bcimring/wheelchair_controller/README.md

# wheelchair_controller
A project involving the control software and hardware required for a functioning electronic wheelchair.
