bcimring/wheelchair_controller/required_hardware.txt

What we need:

Barry 
//- massive capacitor
----- op amps for voltage translation
----- decoupling capacitors
- LCD display
//- Battery Enery Level Detector
//- Wheel Motor
//- motor encoder

Anweshi
- LEDs
- Switches (for locked/run mode)
- potentiometers 
	1 for speed
	1 for steering
	or one joystick type of thing for both
