bcimring/wheelchair_controller/lab_4/ECE298_Lab4_Netlist.TXT

ISIS SCHEMATIC DESCRIPTION FORMAT 8.0
=====================================
Design:   ECE298_Lab4.pdsprj
Doc. no.: <NONE>
Revision: <NONE>
Author:   <NONE>
Created:  2020-12-15
Modified: 2021-08-03

*PROPERTIES,0    

*MODELDEFS,0    

*PARTLIST,83   
+3.3V,PIN,PIN,EID=1A,PACKAGE=PIN
+5V,PIN,PIN,EID=18,PACKAGE=PIN
+12V,PIN,PIN,EID=15,PACKAGE=PIN
C1,AVX0805X7R10N,10n,CODE="Farnell 499-225",EID=7,PACKAGE=0805_CAP
C2,AVX0805X7R10N,10n,CODE="Farnell 499-225",EID=9,PACKAGE=0805_CAP
C3,AVX0805X7R10N,10n,CODE="Farnell 499-225",EID=B,PACKAGE=0805_CAP
C4,C2012Y5V1A106Z,10u,CODE="Digikey 445-1371-1-ND",EID=D,PACKAGE=CAPC2012X100
C5,C2012Y5V1A106Z,10u,CODE="Digikey 445-1371-1-ND",EID=F,PACKAGE=CAPC2012X100
C6,C2012Y5V1A106Z,10u,CODE="Digikey 445-1371-1-ND",EID=1E,PACKAGE=CAPC2012X100
C7,AVX0805X7R10N,10n,CODE="Farnell 499-225",EID=21,PACKAGE=0805_CAP
C8,AVX0805X7R10N,10n,CODE="Farnell 499-225",EID=6,PACKAGE=0805_CAP
C9,AVX0805X7R10N,10n,CODE="Farnell 499-225",EID=25,PACKAGE=0805_CAP
C10,AVX0805X7R10N,10n,CODE="Farnell 499-225",EID=26,PACKAGE=0805_CAP
C11,AVX0805X7R10N,10n,CODE="Farnell 499-225",EID=27,PACKAGE=0805_CAP
C12,B45196H1107M209,100u,CODE="Digikey 495-2191-2-ND",EID=23,PACKAGE=CAPMP3528X210
C13,B45196H1107M209,100u,CODE="Digikey 495-2191-2-ND",EID=29,PACKAGE=CAPMP3528X210
C14,C2012Y5V1A106Z,10u,CODE="Digikey 445-1371-1-ND",EID=37,PACKAGE=CAPC2012X100
CN7,1-534236-9,1-534236-9,CODE=1-534236-9,EID=8,PACKAGE=ECE298_REVTRANS38DIL-1,SUPPLIER=TE_CONNECTIVITY
CN10,1-534236-9,1-534236-9,CODE=1-534236-9,EID=2,PACKAGE=ECE298_REVTRANS38DIL-1,SUPPLIER=TE_CONNECTIVITY
GND,PIN,PIN,EID=24,PACKAGE=PIN
J1,TBLOCK-M2,TBLOCK-M2,EID=5,PACKAGE=TBLOCK-M2
J4,26630201RP2,26630201RP2,CODE="NorComp 26630201RP2",EID=4,PACKAGE=CON2_1X2_HDR_2663
J5,26630201RP2,26630201RP2,CODE="NorComp 26630201RP2",EID=E,PACKAGE=CON2_1X2_HDR_2663
J6,26641201RP2,26641201RP2,CODE="NorComp 26641201RP2",EID=22,PACKAGE=CON12_2X6_HDR_2664
J7,26641001RP2,26641001RP2,CODE="NorComp 26641001RP2",EID=12,PACKAGE=CON10_2X5_HDR_2664
J9,27640602RP2,27640602RP2,CODE="NorComp 27640602RP2",EID=C,PACKAGE=CON6_2X3_HDR_2764
J16,26640801RP2,26640801RP2,CODE="NorComp 26640801RP2",EID=28,PACKAGE=CON8_2X4_HDR_2664
PWM1,PIN,PIN,EID=1C,PACKAGE=PIN
PWM2,PIN,PIN,EID=1B,PACKAGE=PIN
Q1,2N7002,2N7002,CODE="Digikey 2N7002NTR-ND",EID=1D,PACKAGE=SOT95P230X109-3
Q2,2N7002,2N7002,CODE="Digikey 2N7002NTR-ND",EID=2C,PACKAGE=SOT95P230X109-3
Q3,2N7002,2N7002,CODE="Digikey 2N7002NTR-ND",EID=4B,PACKAGE=SOT95P230X109-3
Q4,2N7002,2N7002,CODE="Digikey 2N7002NTR-ND",EID=30,PACKAGE=SOT95P230X109-3
Q17,2N7002,2N7002,CODE="Digikey 2N7002NTR-ND",EID=57,PACKAGE=SOT95P230X109-3
Q18,2N7002,2N7002,CODE="Digikey 2N7002NTR-ND",EID=33,PACKAGE=SOT95P230X109-3
Q19,2N7002,2N7002,CODE="Digikey 2N7002NTR-ND",EID=38,PACKAGE=SOT95P230X109-3
Q20,2N7002,2N7002,CODE="Digikey 2N7002NTR-ND",EID=46,PACKAGE=SOT95P230X109-3
Q21,2N7002,2N7002,CODE="Digikey 2N7002NTR-ND",EID=10,PACKAGE=SOT95P230X109-3
Q22,2N7002,2N7002,CODE="Digikey 2N7002NTR-ND",EID=4E,PACKAGE=SOT95P230X109-3
Q23,2N7002,2N7002,CODE="Digikey 2N7002NTR-ND",EID=53,PACKAGE=SOT95P230X109-3
Q24,2N7002,2N7002,CODE="Digikey 2N7002NTR-ND",EID=56,PACKAGE=SOT95P230X109-3
Q25,2N7002,2N7002,CODE="Digikey 2N7002NTR-ND",EID=5E,PACKAGE=SOT95P230X109-3
Q26,2N7002,2N7002,CODE="Digikey 2N7002NTR-ND",EID=13,PACKAGE=SOT95P230X109-3
Q27,2N7002,2N7002,CODE="Digikey 2N7002NTR-ND",EID=16,PACKAGE=SOT95P230X109-3
Q28,2N7002,2N7002,CODE="Digikey 2N7002NTR-ND",EID=19,PACKAGE=SOT95P230X109-3
R1,ERA-6YEB104V,100K,CODE="Digikey P100KZTR-ND",EID=5F,PACKAGE=RESC2012X50,PRIMTYPE=RESISTOR
R2,ERA-6YEB104V,100K,CODE="Digikey P100KZTR-ND",EID=60,PACKAGE=RESC2012X50,PRIMTYPE=RESISTOR
R3,ERA-6YEB104V,100K,CODE="Digikey P100KZTR-ND",EID=2B,PACKAGE=RESC2012X50,PRIMTYPE=RESISTOR
R4,RT0805DRE07300KL,300k,CODE="Digikey RT0805DRE07300KL-ND",EID=6D,PACKAGE=RESC2012X50,PRIMTYPE=RESISTOR
R13,RT0805DRE07165KL,165k,CODE="Digikey RT0805DRE07165KL-ND",EID=78,PACKAGE=RESC2012X50,PRIMTYPE=RESISTOR
R14,ERA-6YEB104V,100K,CODE="Digikey P100KZTR-ND",EID=6E,PACKAGE=RESC2012X50,PRIMTYPE=RESISTOR
R16,ERA-6YEB104V,100K,CODE="Digikey P100KZTR-ND",EID=2F,PACKAGE=RESC2012X50,PRIMTYPE=RESISTOR
R17,RT0805DRE07165KL,165k,CODE="Digikey RT0805DRE07165KL-ND",EID=79,PACKAGE=RESC2012X50,PRIMTYPE=RESISTOR
R18,RT0805DRE07330KL,330k,CODE="Digikey RT0805DRE07330KL-ND",EID=7A,PACKAGE=RESC2012X50,PRIMTYPE=RESISTOR
R19,9C08052A2000FKHFT,200,CODE="Digikey 311-200CTR-ND",EID=73,PACKAGE=RESC2012X50,PRIMTYPE=RESISTOR
R20,RT0805DRE07330KL,330k,CODE="Digikey RT0805DRE07330KL-ND",EID=7B,PACKAGE=RESC2012X50,PRIMTYPE=RESISTOR
R21,RT0805DRE07255KL,255k,CODE="Digikey RT0805DRE07255KL-ND",EID=3,PACKAGE=RESC2012X50,PRIMTYPE=RESISTOR
R22,RT0805DRE0764K9L,64.9k,CODE="Digikey RT0805DRE0764K9L-ND",EID=74,PACKAGE=RESC2012X50,PRIMTYPE=RESISTOR
R26,RT0805DRE0764K9L,64.9k,CODE="Digikey RT0805DRE0764K9L-ND",EID=75,PACKAGE=RESC2012X50,PRIMTYPE=RESISTOR
R27,ERA-6YEB104V,100K,CODE="Digikey P100KZTR-ND",EID=32,PACKAGE=RESC2012X50,PRIMTYPE=RESISTOR
R28,RT0805DRE07300KL,300k,CODE="Digikey RT0805DRE07300KL-ND",EID=6C,PACKAGE=RESC2012X50,PRIMTYPE=RESISTOR
R29,RT0805DRE07165KL,165k,CODE="Digikey RT0805DRE07165KL-ND",EID=76,PACKAGE=RESC2012X50,PRIMTYPE=RESISTOR
R30,RT0805DRE07165KL,165k,CODE="Digikey RT0805DRE07165KL-ND",EID=77,PACKAGE=RESC2012X50,PRIMTYPE=RESISTOR
R31,RT0805DRE07330KL,330k,CODE="Digikey RT0805DRE07330KL-ND",EID=7C,PACKAGE=RESC2012X50,PRIMTYPE=RESISTOR
R32,RT0805DRE07330KL,330k,CODE="Digikey RT0805DRE07330KL-ND",EID=7D,PACKAGE=RESC2012X50,PRIMTYPE=RESISTOR
R33,ERA-6YEB104V,100K,CODE="Digikey P100KZTR-ND",EID=36,PACKAGE=RESC2012X50,PRIMTYPE=RESISTOR
R34,ERA-6YEB104V,100K,CODE="Digikey P100KZTR-ND",EID=3D,PACKAGE=RESC2012X50,PRIMTYPE=RESISTOR
R35,ERA-6YEB104V,100K,CODE="Digikey P100KZTR-ND",EID=48,PACKAGE=RESC2012X50,PRIMTYPE=RESISTOR
R36,9C08052A2000FKHFT,200,CODE="Digikey 311-200CTR-ND",EID=11,PACKAGE=RESC2012X50,PRIMTYPE=RESISTOR
R37,ERA-6YEB104V,100K,CODE="Digikey P100KZTR-ND",EID=50,PACKAGE=RESC2012X50,PRIMTYPE=RESISTOR
R38,ERA-6YEB104V,100K,CODE="Digikey P100KZTR-ND",EID=55,PACKAGE=RESC2012X50,PRIMTYPE=RESISTOR
R39,ERA-6YEB104V,100K,CODE="Digikey P100KZTR-ND",EID=5B,PACKAGE=RESC2012X50,PRIMTYPE=RESISTOR
R40,ERA-6YEB104V,100K,CODE="Digikey P100KZTR-ND",EID=62,PACKAGE=RESC2012X50,PRIMTYPE=RESISTOR
R41,9C08052A2000FKHFT,200,CODE="Digikey 311-200CTR-ND",EID=14,PACKAGE=RESC2012X50,PRIMTYPE=RESISTOR
R42,9C08052A2000FKHFT,200,CODE="Digikey 311-200CTR-ND",EID=17,PACKAGE=RESC2012X50,PRIMTYPE=RESISTOR
R43,9C08052A2000FKHFT,200,CODE="Digikey 311-200CTR-ND",EID=1F,PACKAGE=RESC2012X50,PRIMTYPE=RESISTOR
RS,PIN,PIN,EID=1,PACKAGE=PIN
U1,LM2904LVIDDF,LM2904LVIDDF,EID_A=20,PACKAGE=SOT65P275X110-8,SPICELIB=TEXAS.SML,SPICEMODEL=LM2904LV,SPICEPINS="+IP,-IP,V+,V-,OP"
U3,4049,4049,EID_A=35,EID_B=4F,EID_C=4C,EID_D=2A,EID_F=61,ITFMOD=CMOS,MODFILE=40INV,PACKAGE=DIL16,VDD=+5.0V,VOLTAGE=5V,VSS=GND
U4,DRV8871,DRV8871,EID=2D,PACKAGE=SOIC127P600X170-9
U6,DRV8871,DRV8871,EID=34,PACKAGE=SOIC127P600X170-9
U7,4049,4049,EID_A=2E,EID_B=39,EID_C=47,EID_D=31,EID_E=58,EID_F=54,ITFMOD=CMOS,MODFILE=40INV,PACKAGE=DIL16,VDD=+5.0V,VOLTAGE=5V,VSS=GND
U10,74HCT238,74HCT238,EID=A,ITFMOD=TTLHCT,PACKAGE=DIL16,VCC=+5.0V

*NETLIST,79   
DRV1 IN1,3,CLASS=SIGNAL
DRV1 IN1,LBL
U4,IP,3
U10,OP,15

DRV1 IN2,3,CLASS=SIGNAL
DRV1 IN2,LBL
U4,IP,2
U10,OP,14

DRV1_OUT1,3,CLASS=POWER
DRV1_OUT1,LBL
U4,OP,6
J6,PS,10

DRV1_OUT2,3,CLASS=POWER
DRV1_OUT2,LBL
U4,OP,8
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
+5.0V,PR
J6,PS,4
C12,PS,1
J6,PS,3
C13,PS,1
C11,PS,1
C10,PS,1
C9,PS,1
R43,PS,1
R42,PS,1
R41,PS,1
R36,PS,1
CN7,PS,18
U10,PP,16
U3,PP,1
R40,PS,1
U7,PP,1
R39,PS,1
R38,PS,1
R37,PS,1
R35,PS,1
R34,PS,1
R33,PS,1
R27,PS,1
R16,PS,1
R3,PS,1
C5,PS,1
+5V,PS,1
R19,PS,1
R2,PS,1
C1,PS,1
J7,PS,1

+12.0V,11,CLASS=POWER
+12.0V,PR
U1,PP,8
C7,PS,1
U1,IP,2
C4,PS,1
J1,PS,1
+12V,PS,1
U6,PP,5
C2,PS,1
U4,PP,5
C3,PS,1

GND,66,CLASS=POWER
GND,PR
C13,PS,2
C12,PS,2
J6,PS,2
J6,PS,1
C11,PS,2
C10,PS,2
C9,PS,2
GND,PS,1
Q28,PS,2
Q27,PS,2
Q26,PS,2
Q21,PS,2
CN10,PS,9
CN10,PS,32
CN10,PS,20
CN7,PS,8
CN7,PS,22
CN7,PS,20
CN7,PS,19
C8,PS,2
U10,PP,8
U3,PP,8
Q25,PS,2
U7,PP,8
Q24,PS,2
Q23,PS,2
Q22,PS,2
Q20,PS,2
Q19,PS,2
Q18,PS,2
Q4,PS,2
Q2,PS,2
Q1,PS,2
C7,PS,2
U1,PP,4
C6,PS,2
C14,PS,2
C5,PS,2
C3,PS,2
C2,PS,2
C1,PS,2
J1,PS,2
C4,PS,2
R32,PS,2
R31,PS,2
R14,PS,2
R1,PS,2
Q17,PS,2
Q3,PS,2
U10,IP,6
U10,IP,3
U6,PP,7
U6,PP,9
U6,PP,1
R22,PS,2
U4,PP,7
U4,PP,9
U4,PP,1
R26,PS,2
R20,PS,2
R18,PS,2
J9,PS,6
J9,PS,5
J7,PS,3
J7,PS,5
