bcimring/wheelchair_controller/lab_1/lab_report_images.docx

Brushless Motor Images:

Symbol:

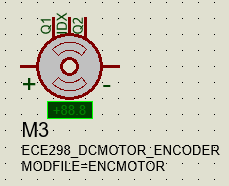
[picture p1: figure]
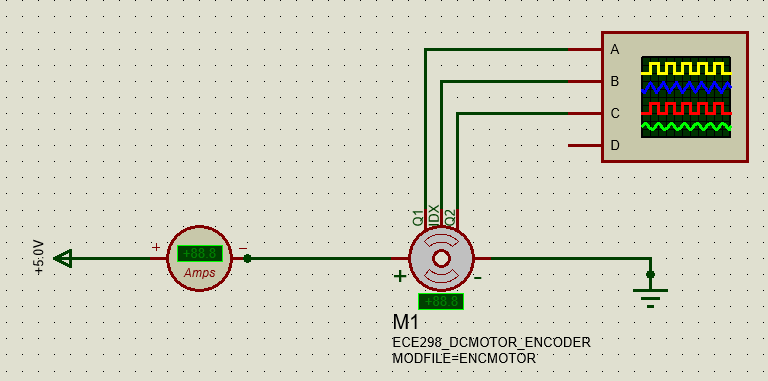
[picture p2: figure]

1 V, 1 pin

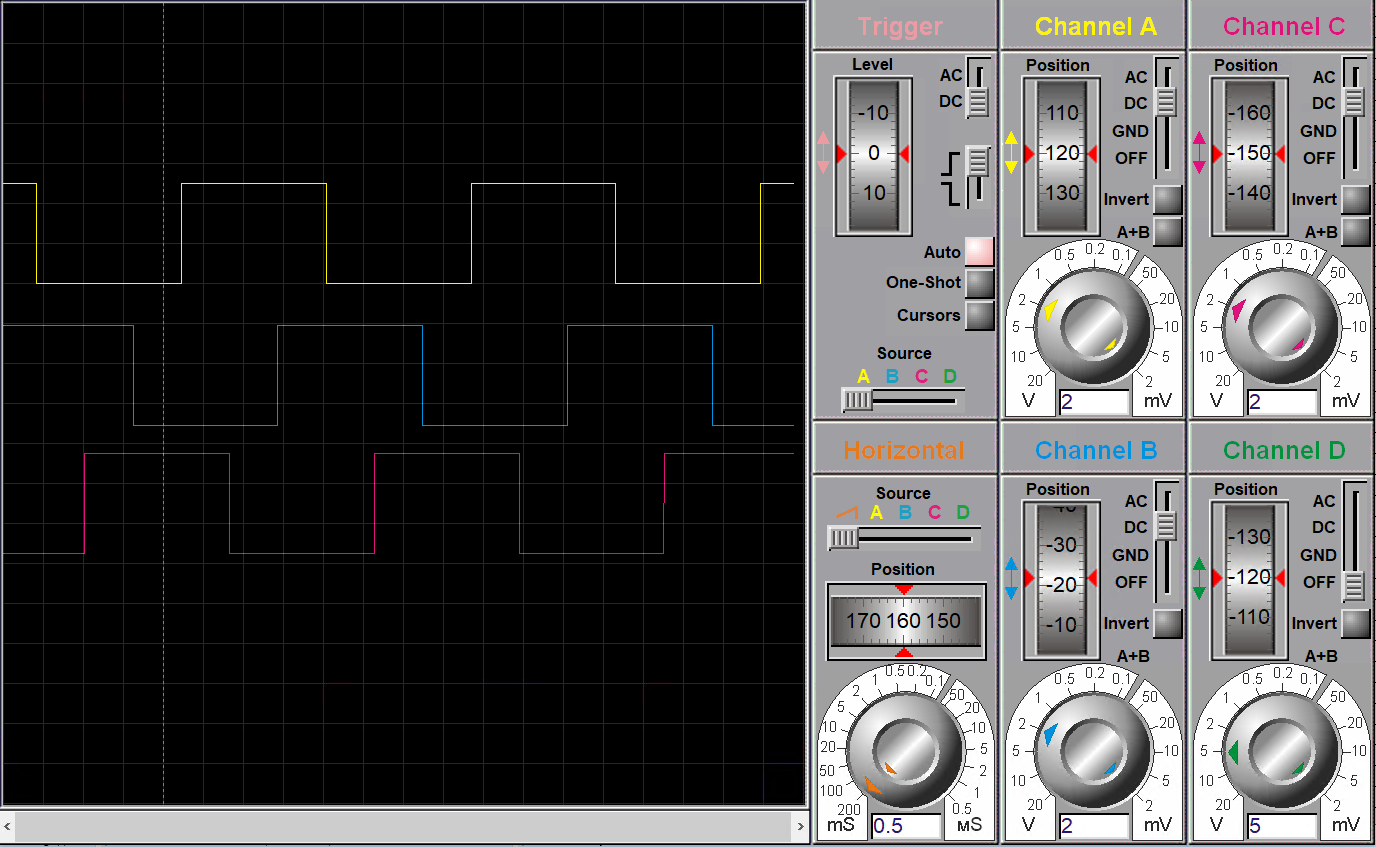
[picture p3: figure]
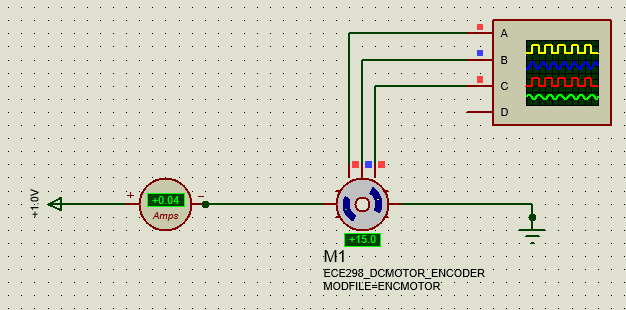
[picture p4: figure]

-1 V, 1 pin:

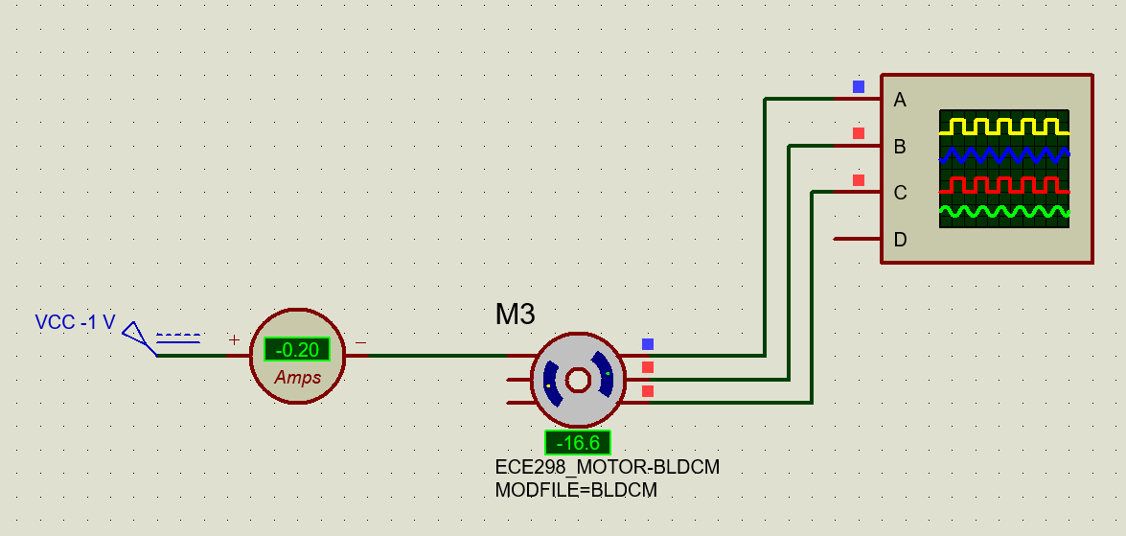
[picture p5: figure]
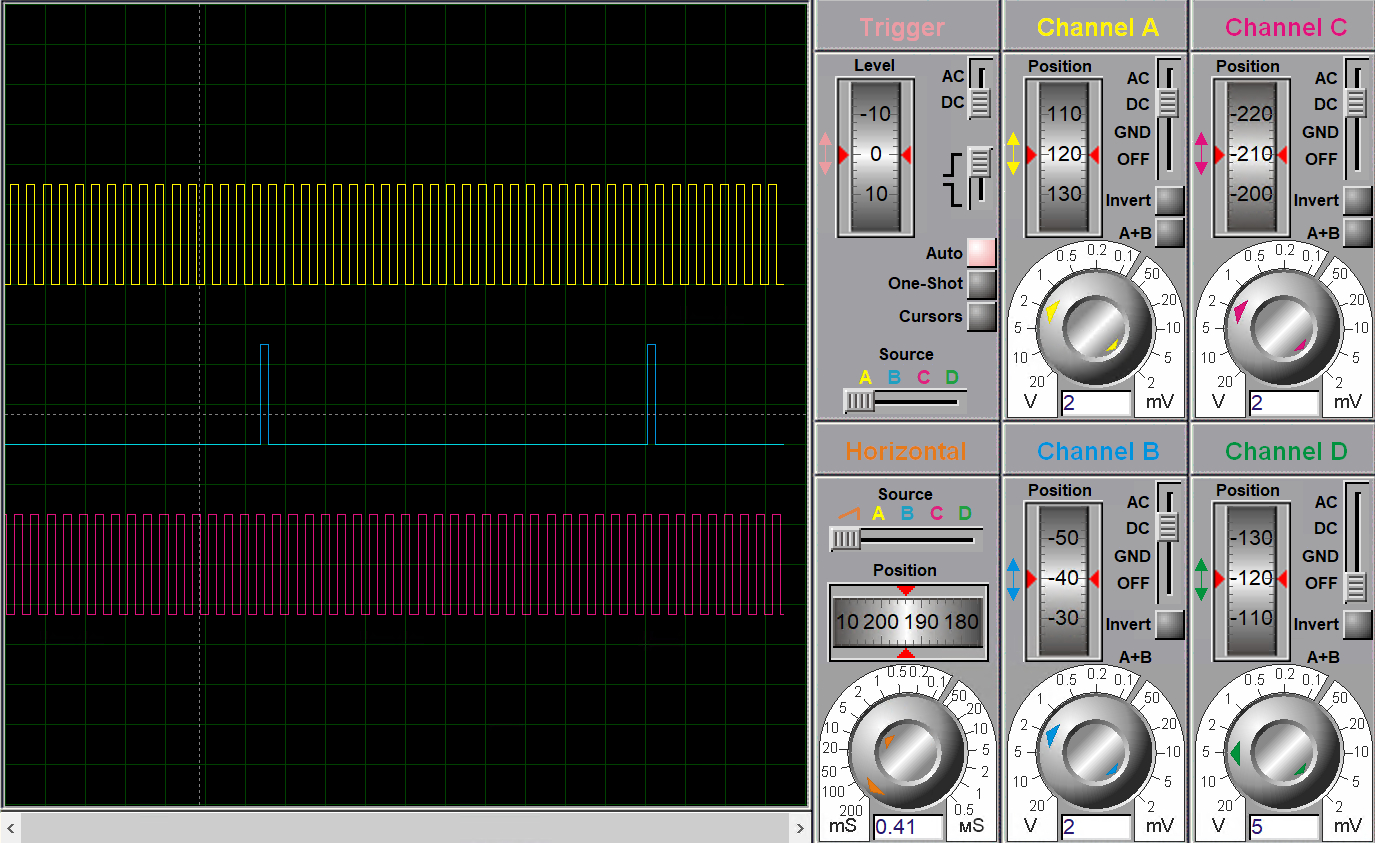
[picture p6: figure]
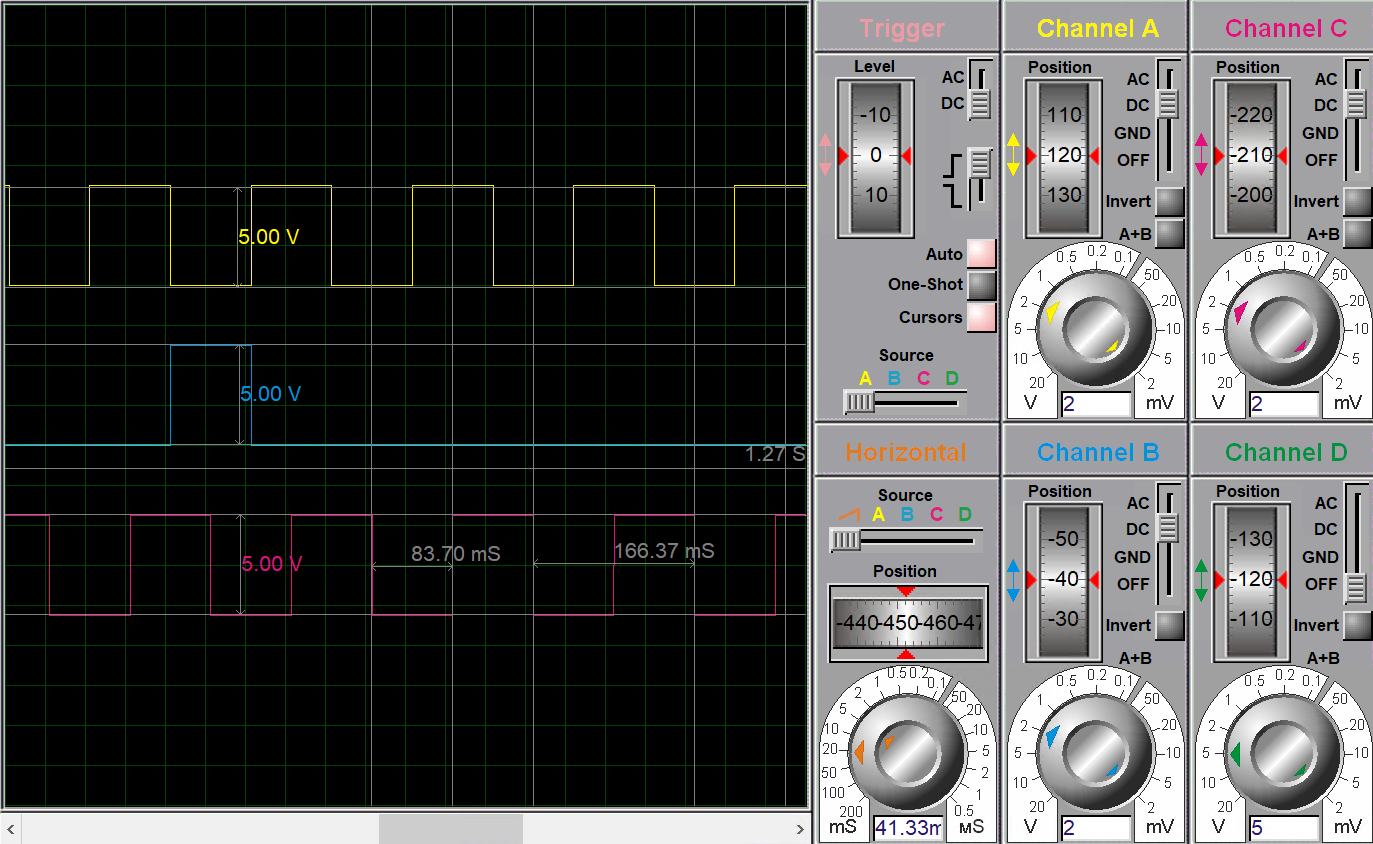
[picture p7: figure]

2 V, 1 pin:

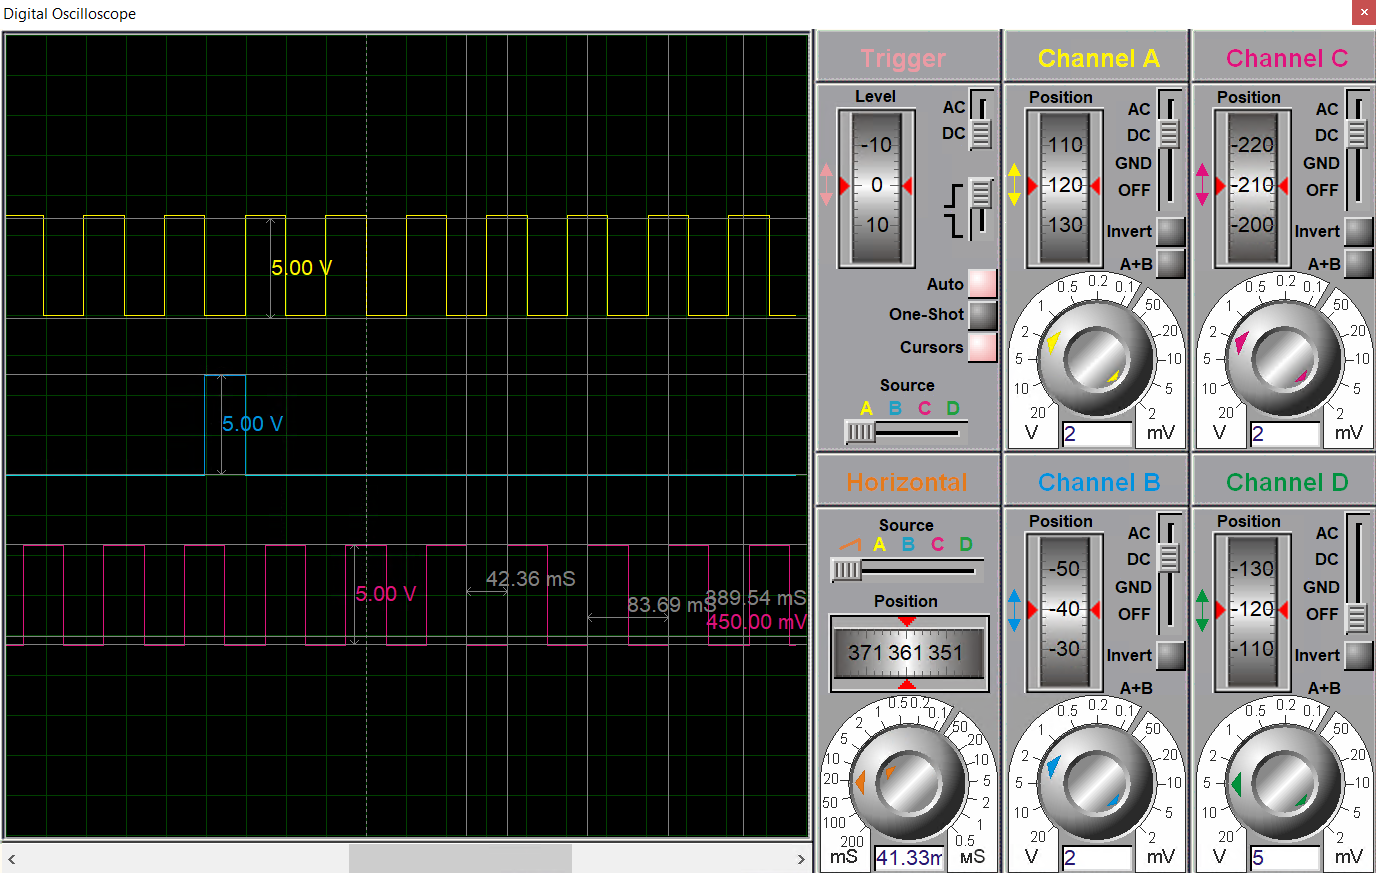
[picture p8: figure]
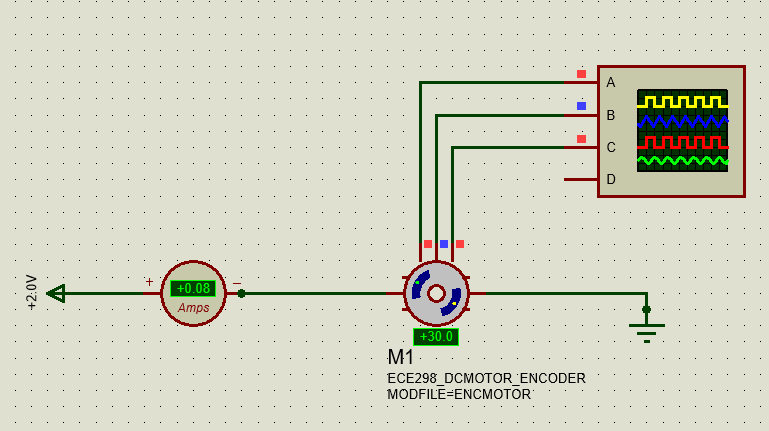
[picture p9: figure]

-1 V:

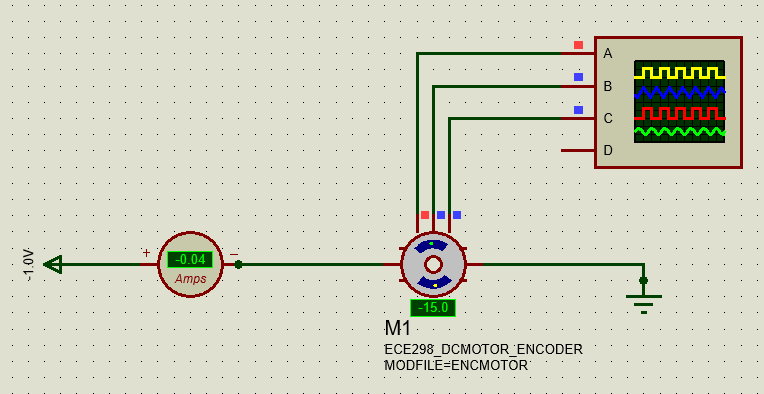
[picture p10: figure]
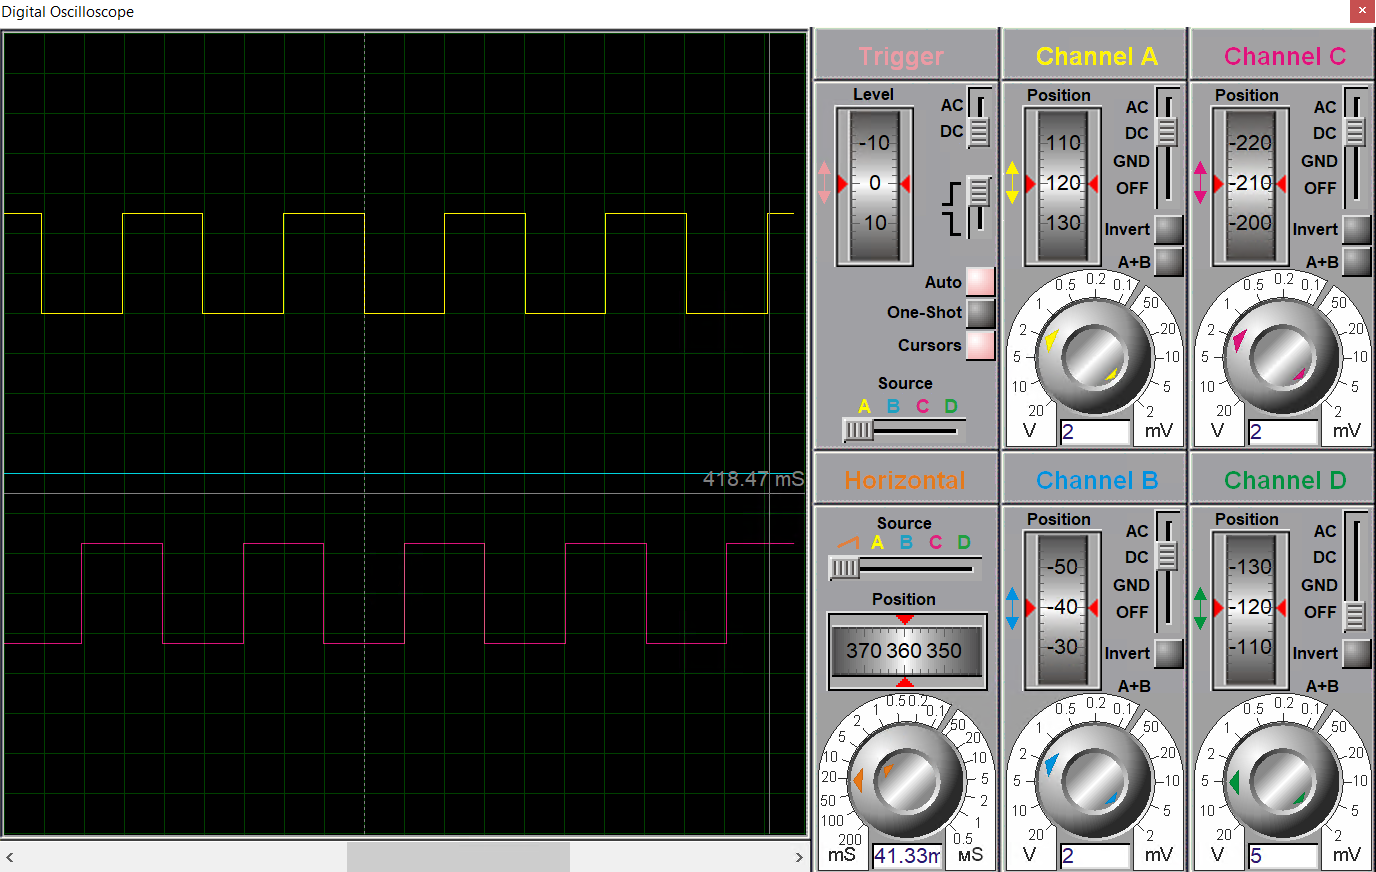
[picture p11: figure]

Battery voltage level detector:

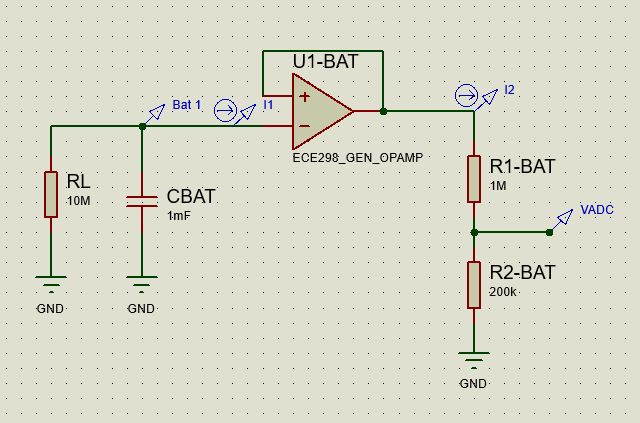
[picture p12: figure]
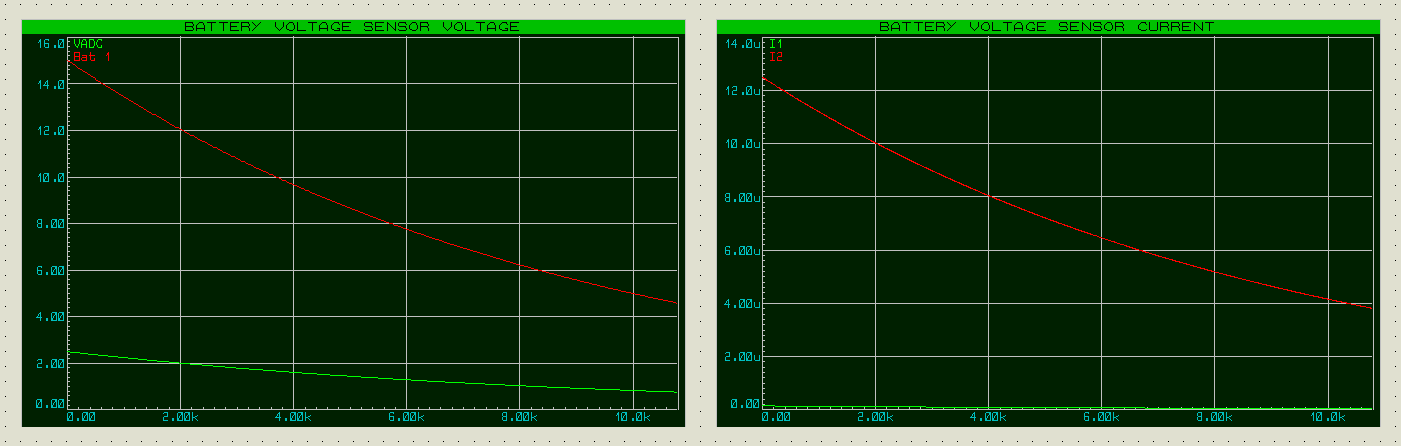
[picture p13: figure]

LCD:

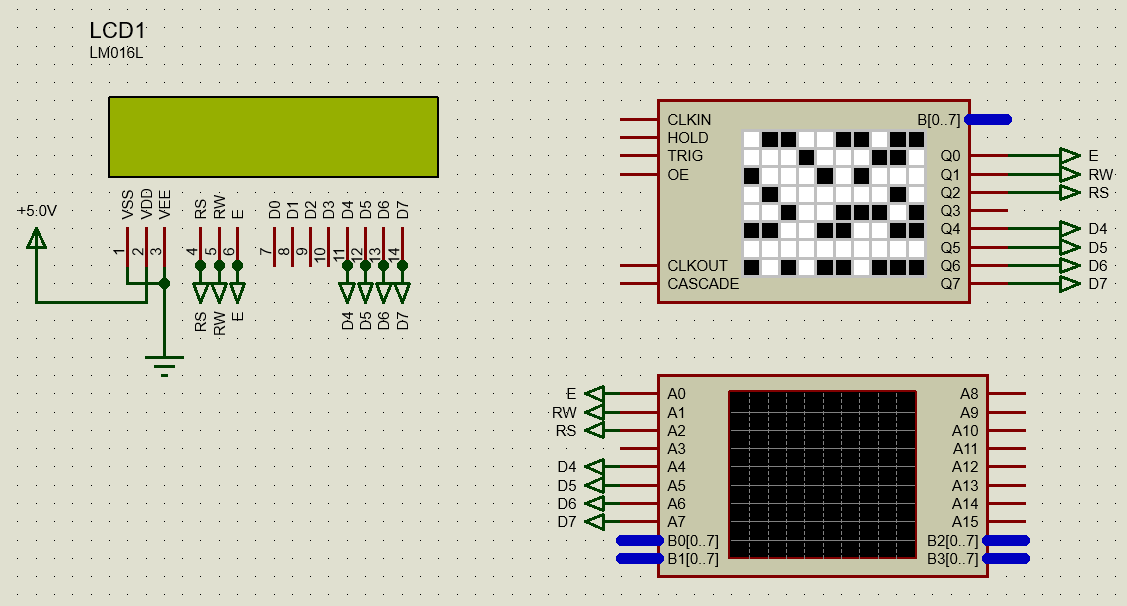
[picture p14: figure]
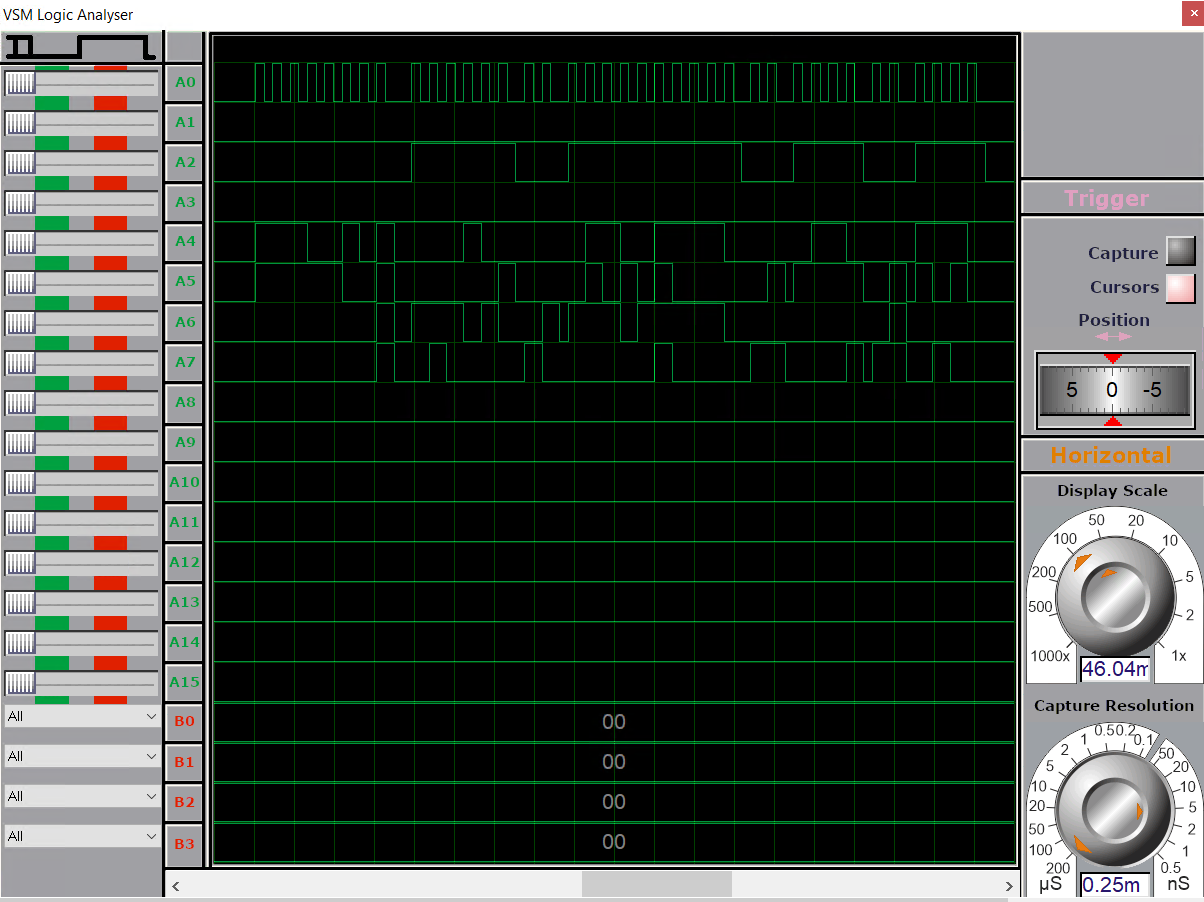
[picture p15: figure]

LED picture:

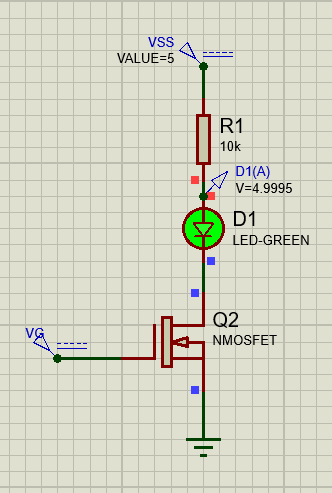
[picture p16: figure]

Petentiometer (Low-High):

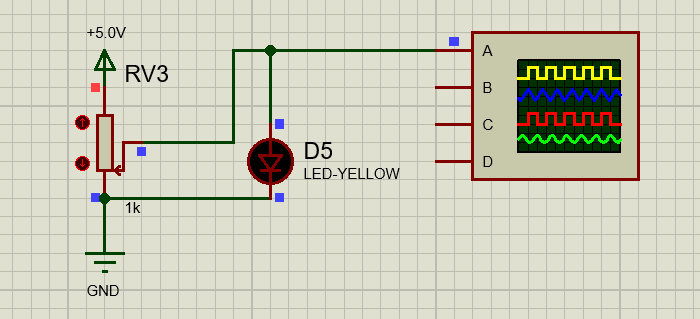
[picture p17: figure]
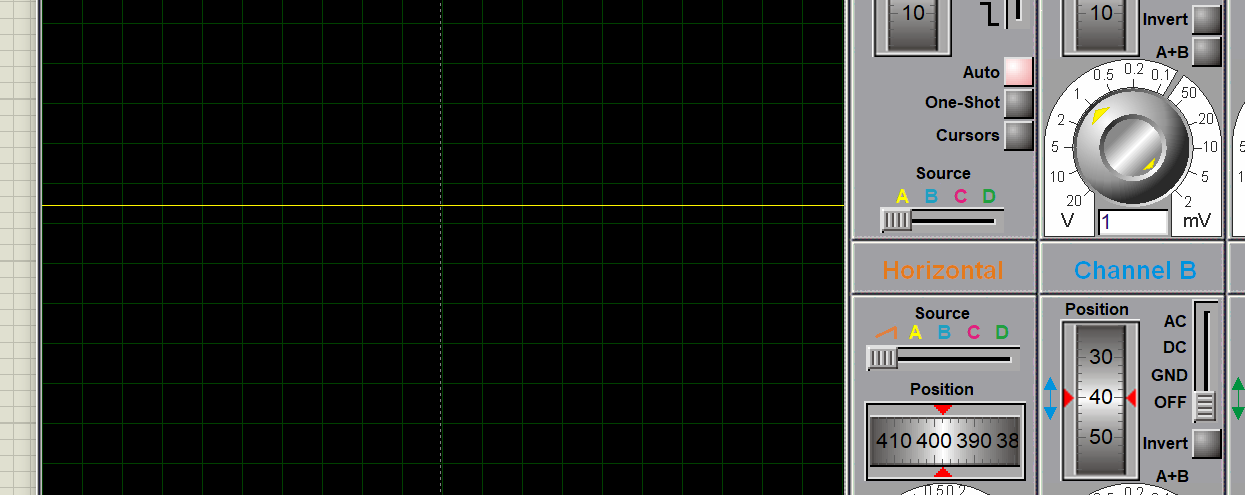
[picture p18: figure]
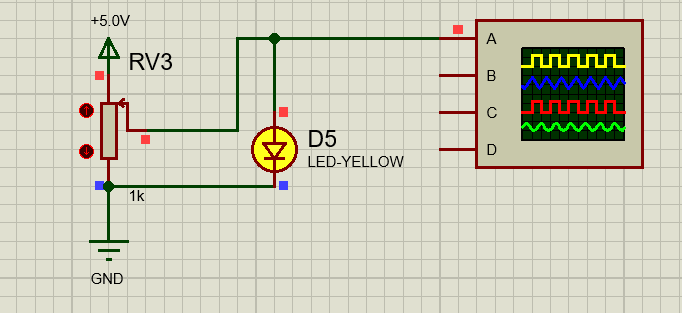
[picture p19: figure]
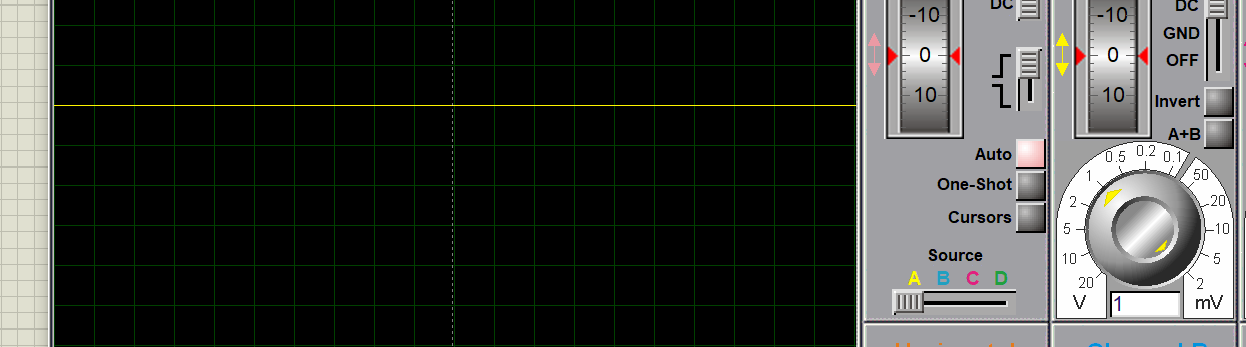
[picture p20: figure]

Switch (Off-On):

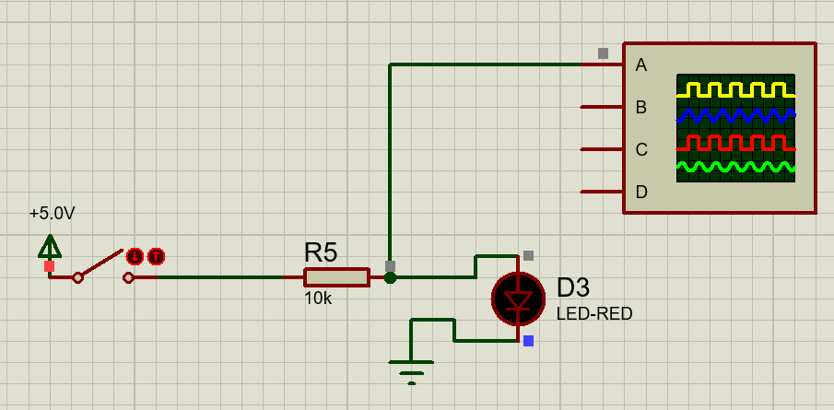
[picture p21: figure]
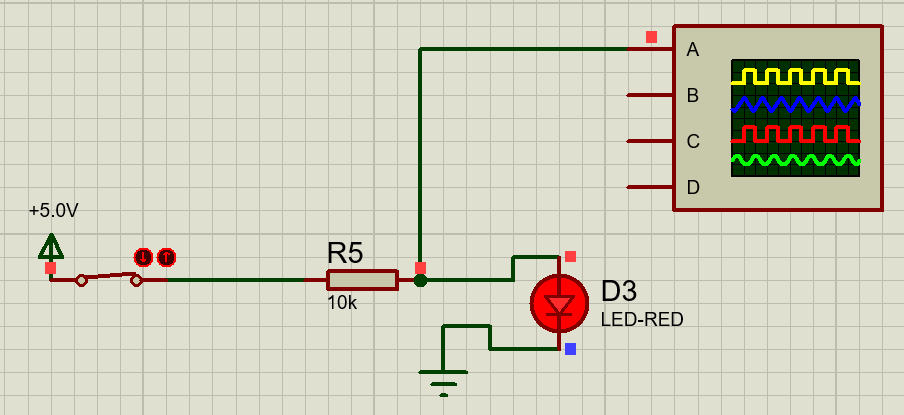
[picture p22: figure]
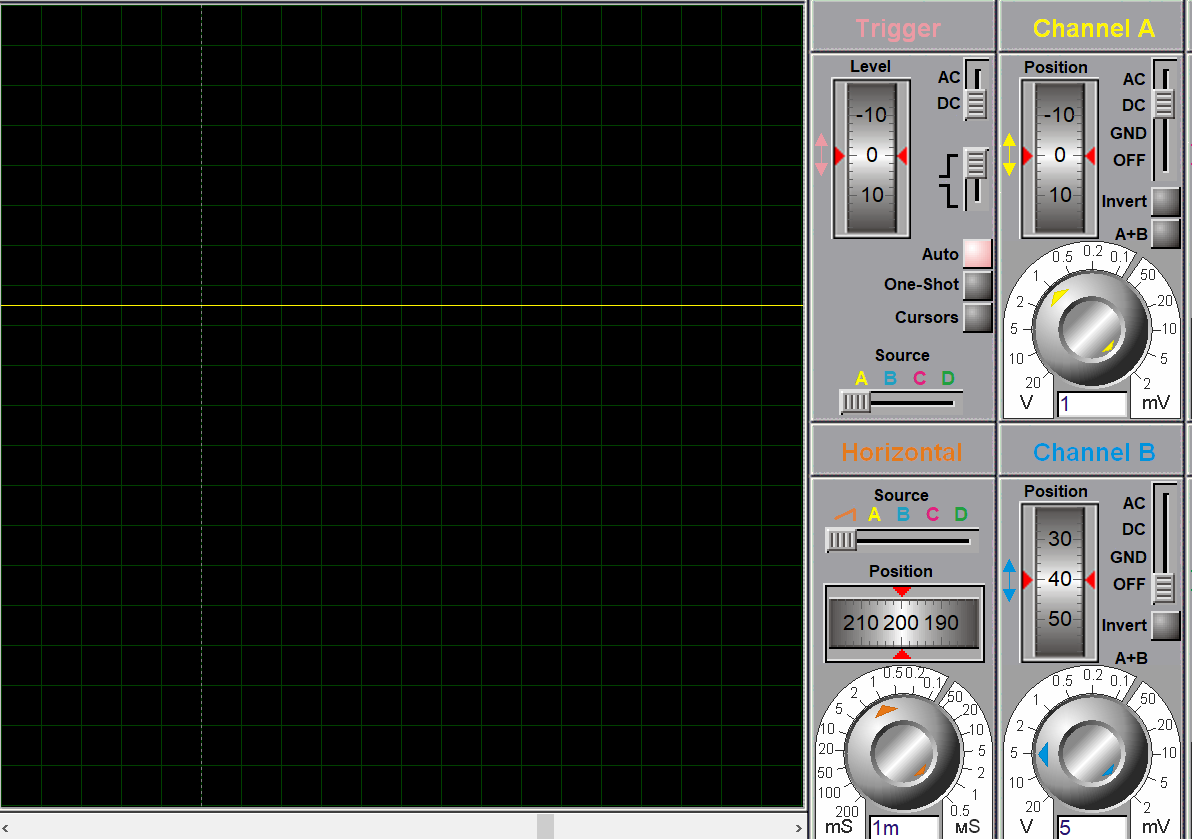
[picture p23: figure]
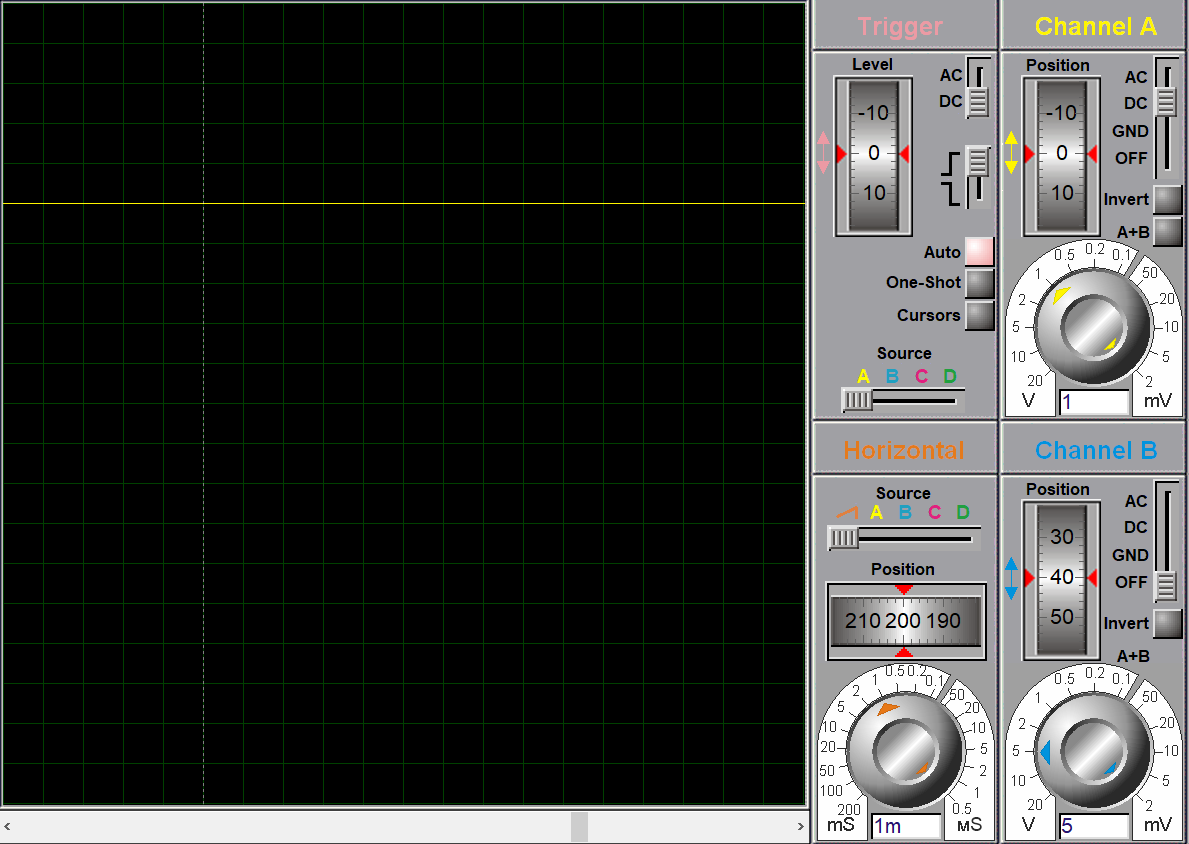
[picture p24: figure]

Push button (On then Off):

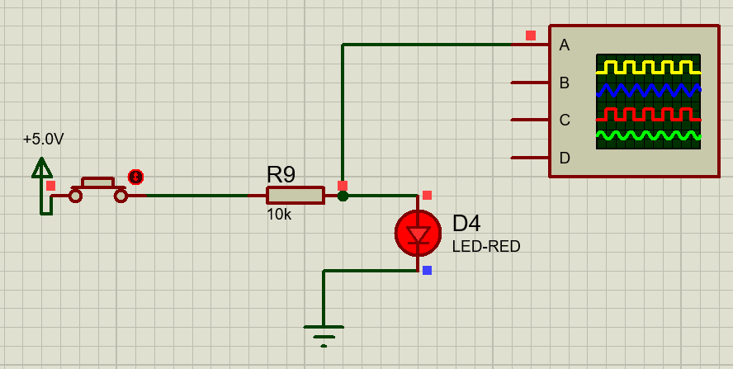
[picture p25: figure]
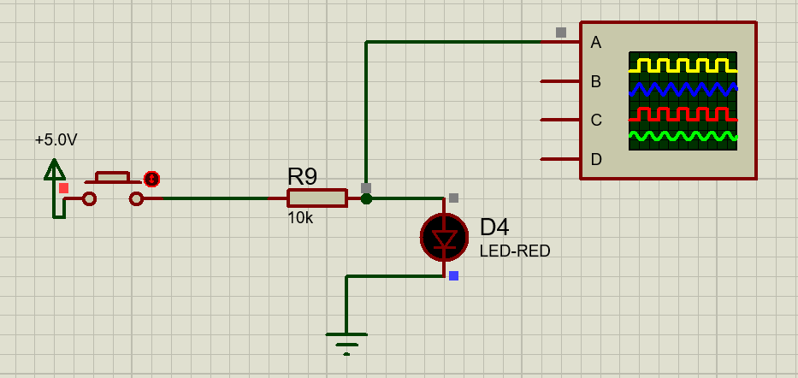
[picture p26: figure]
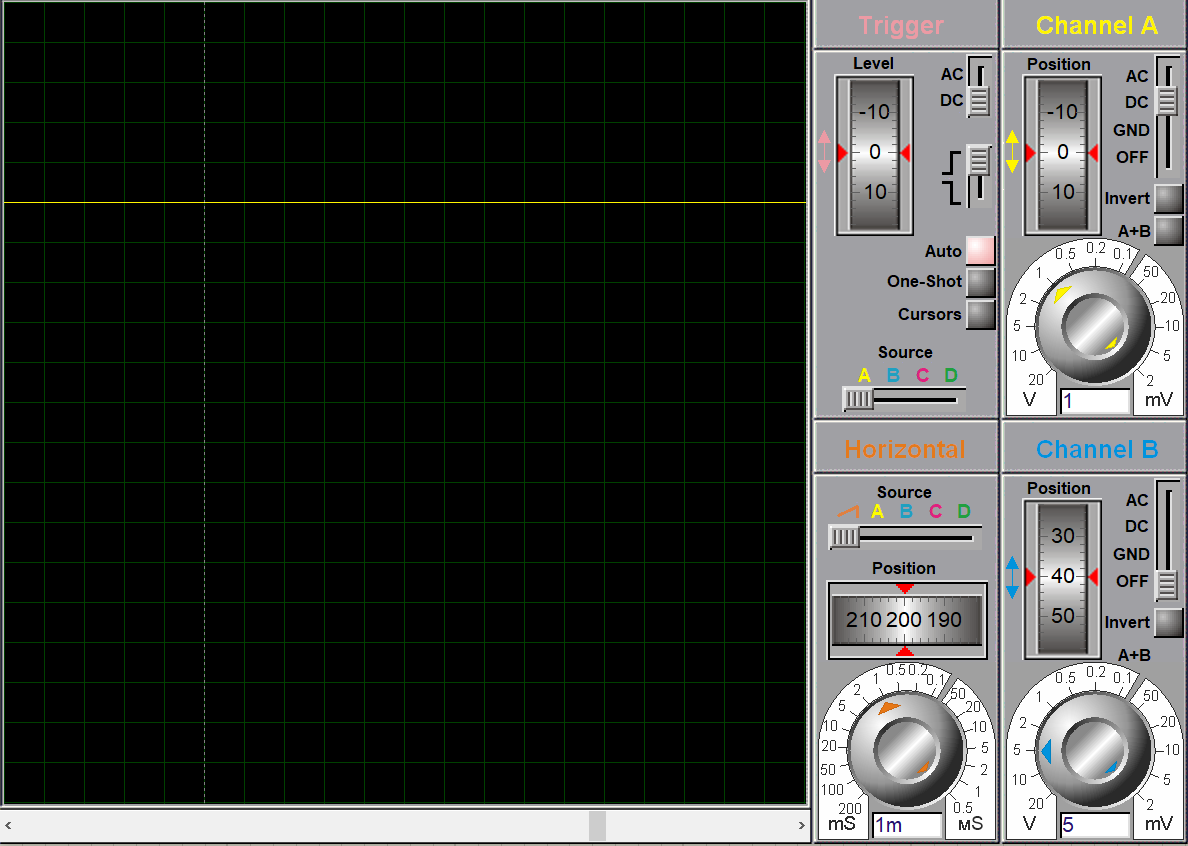
[picture p27: figure]
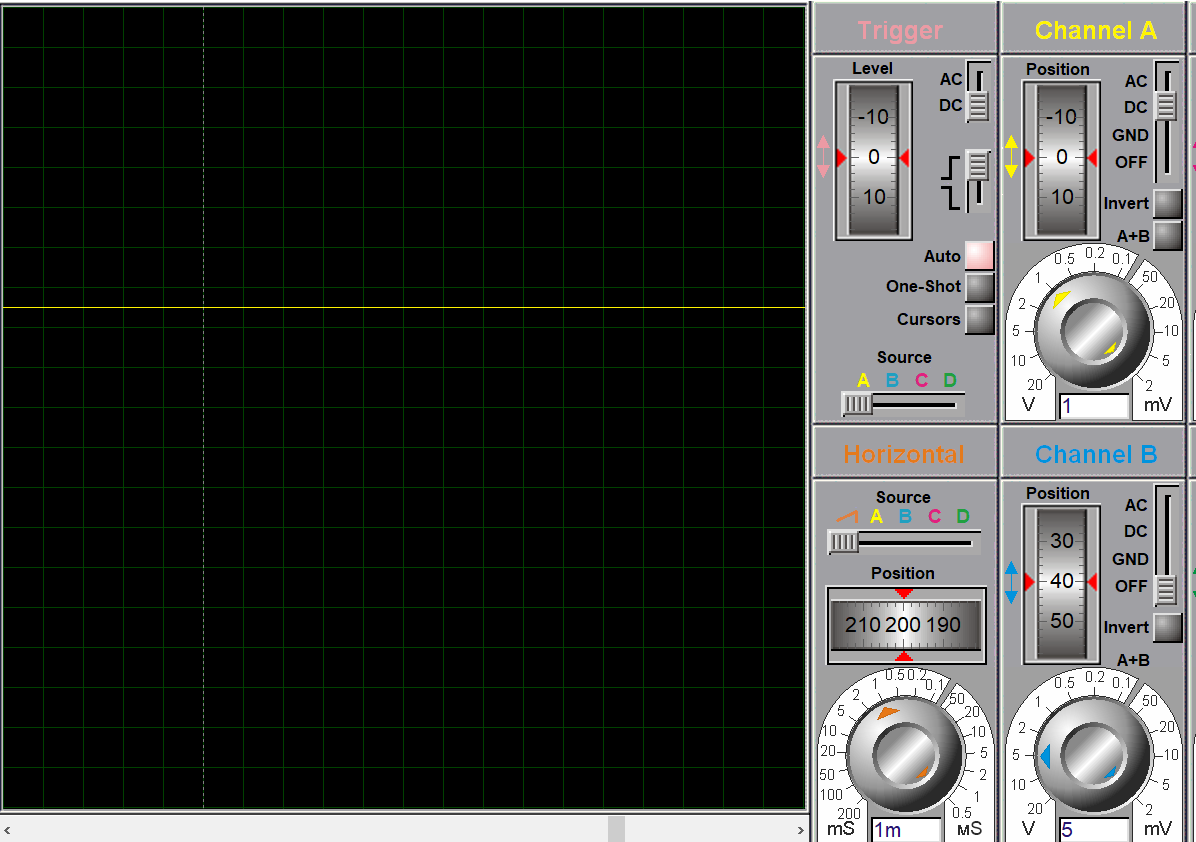
[picture p28: figure]
