bcimring/wheelchair_controller/lab_2/lab_2_pics.docx

Motor+motor_encoder+motor_controller:

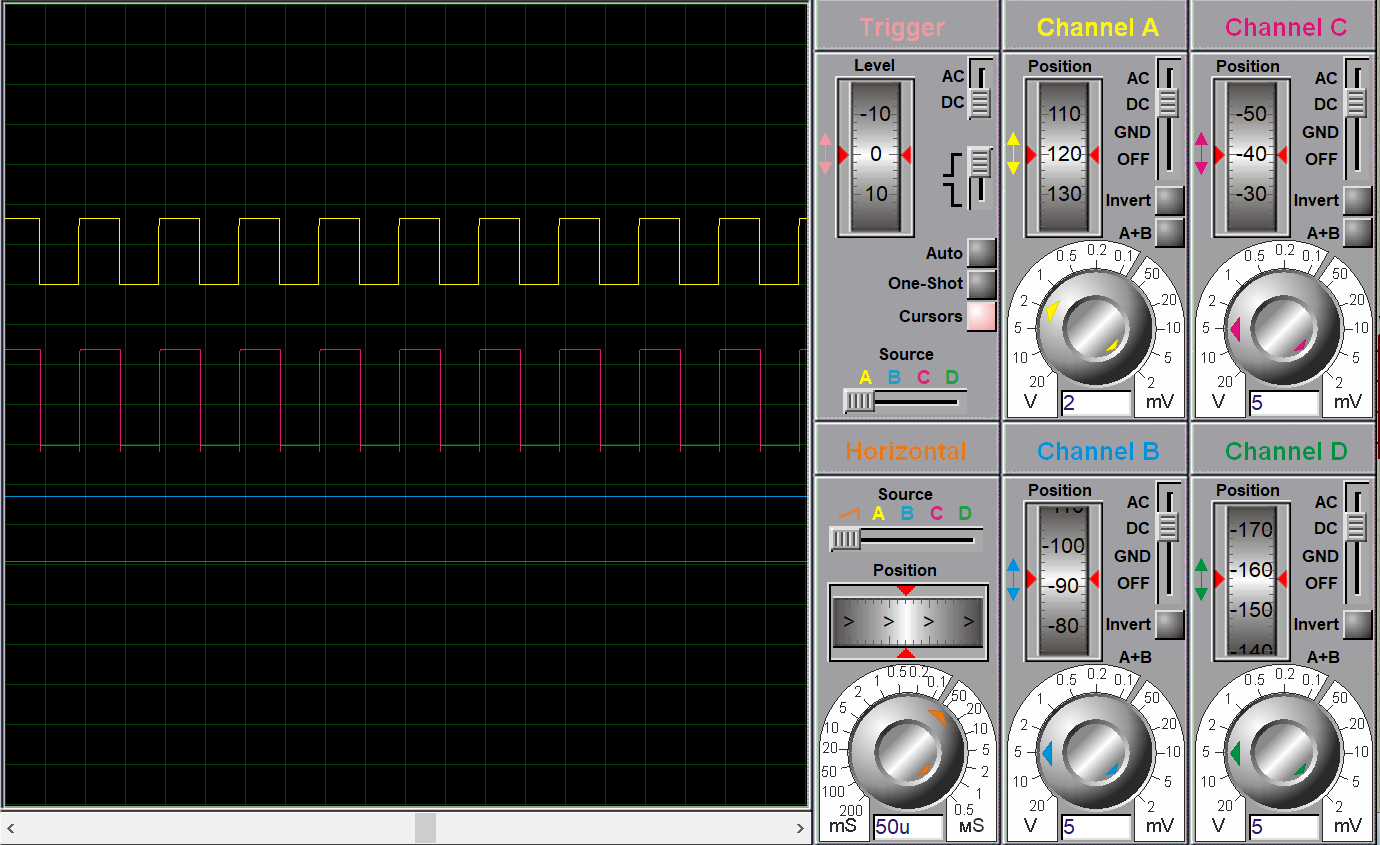
[picture p83: figure]
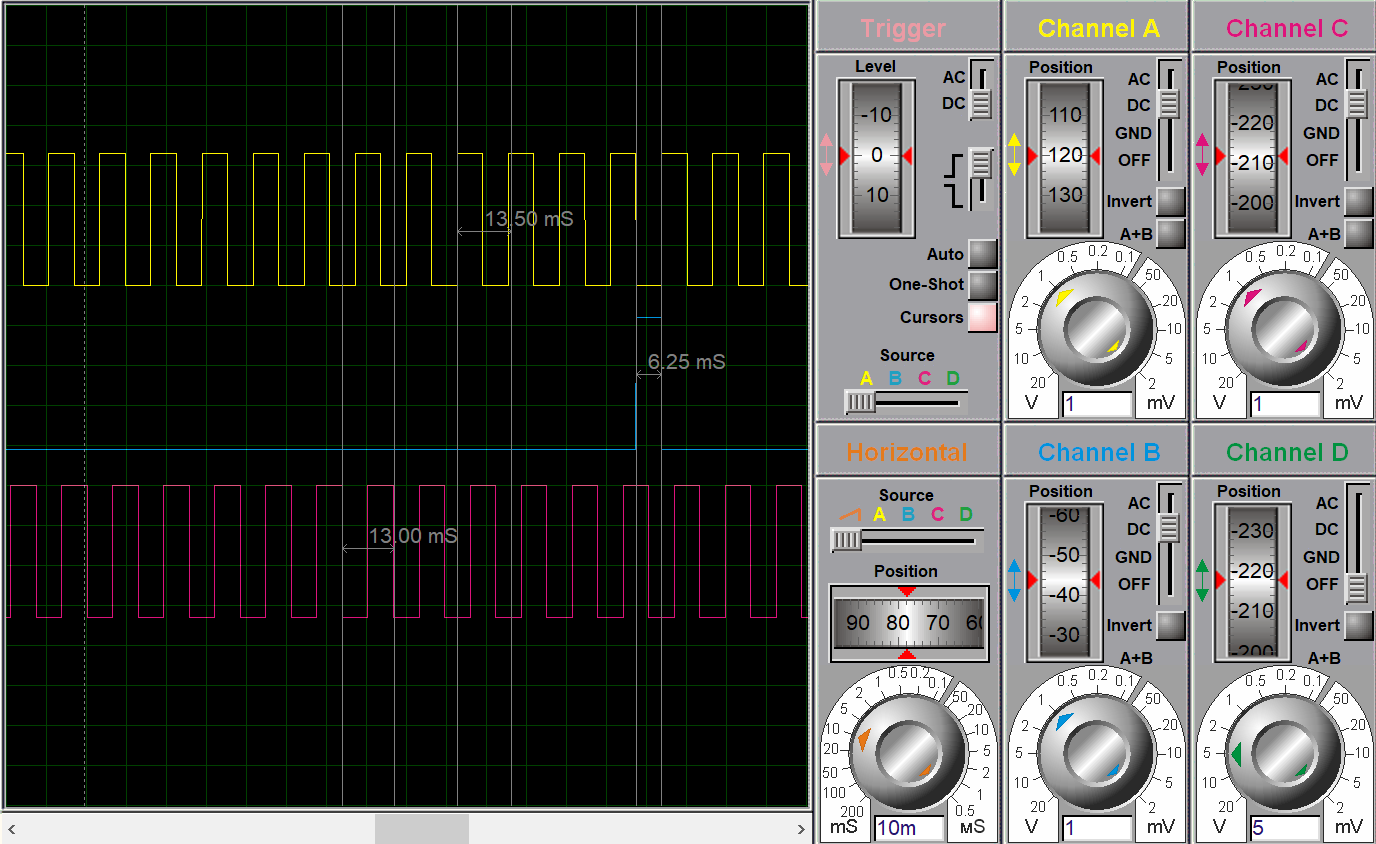
[picture p84: figure]
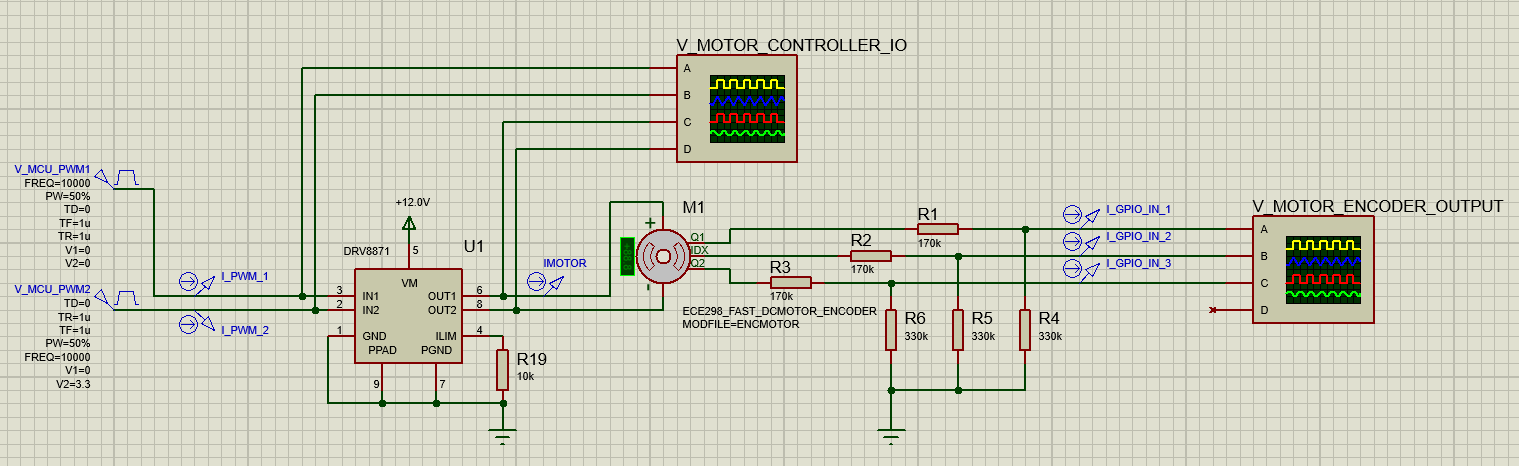
[picture p85: figure]
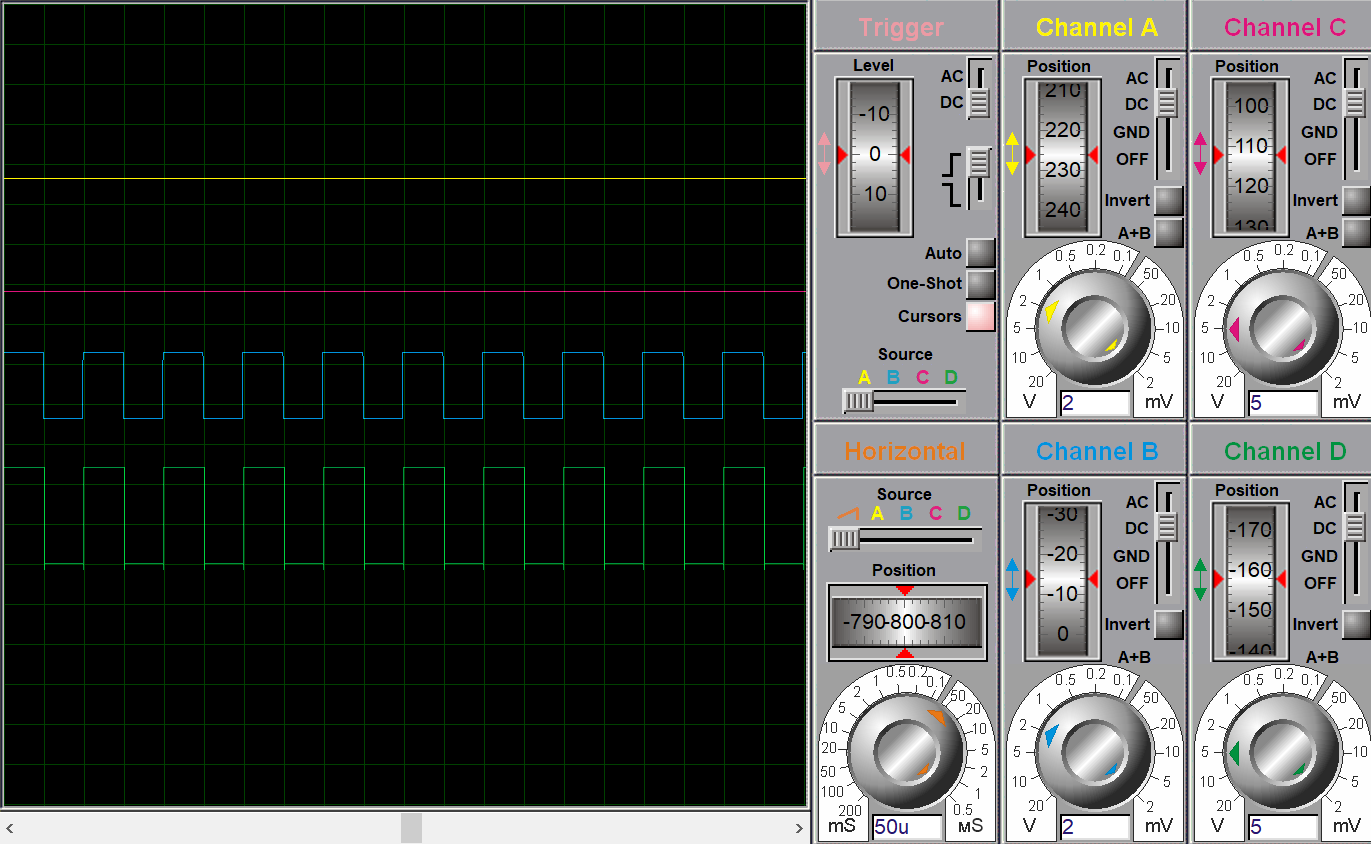
[picture p86: figure]
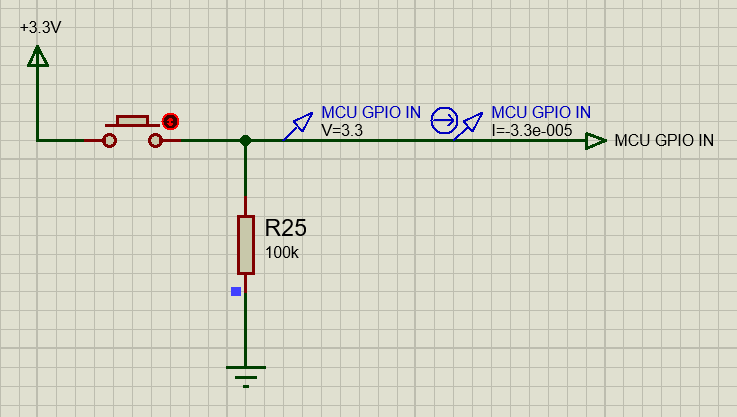
[picture p87: figure]
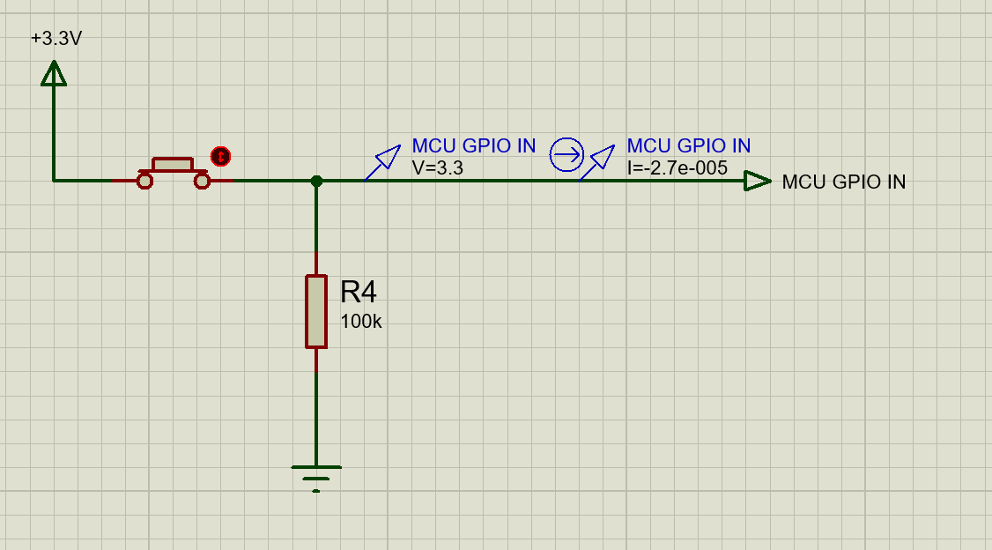
[picture p88: figure]
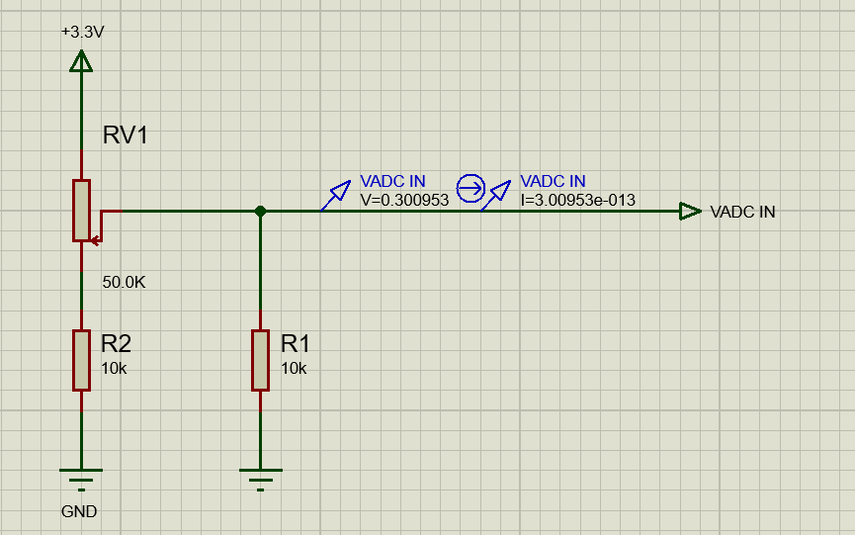
[picture p89: figure]
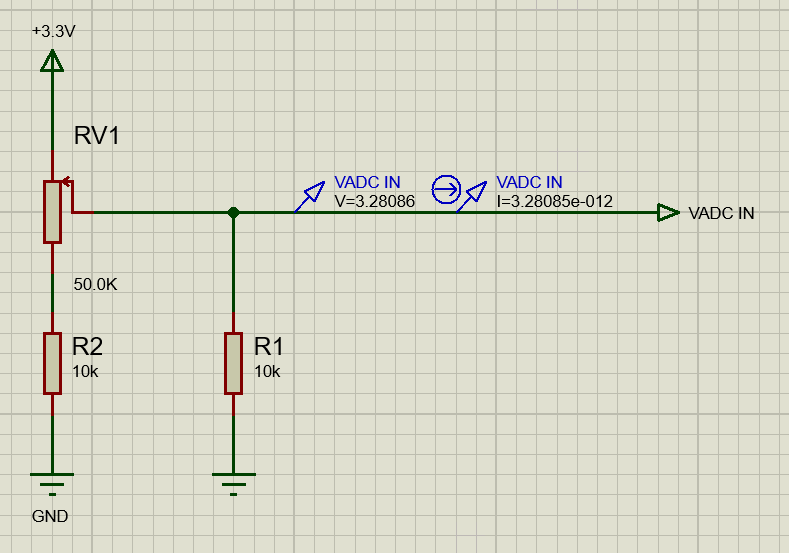
[picture p90: figure]
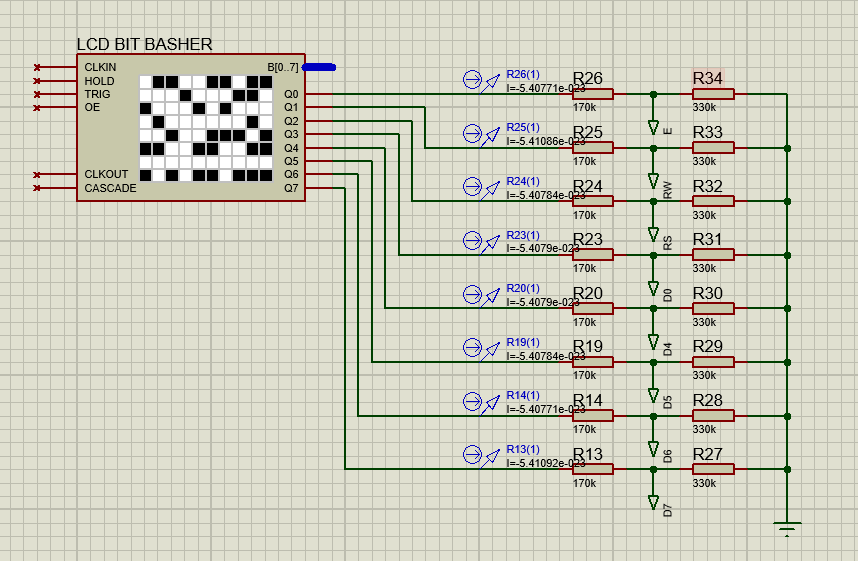
[picture p91: figure]
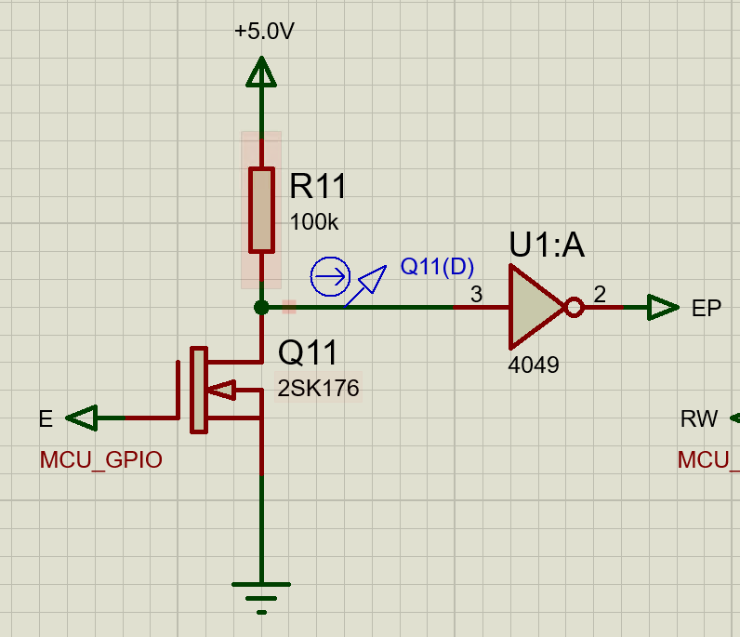
[picture p92: figure]
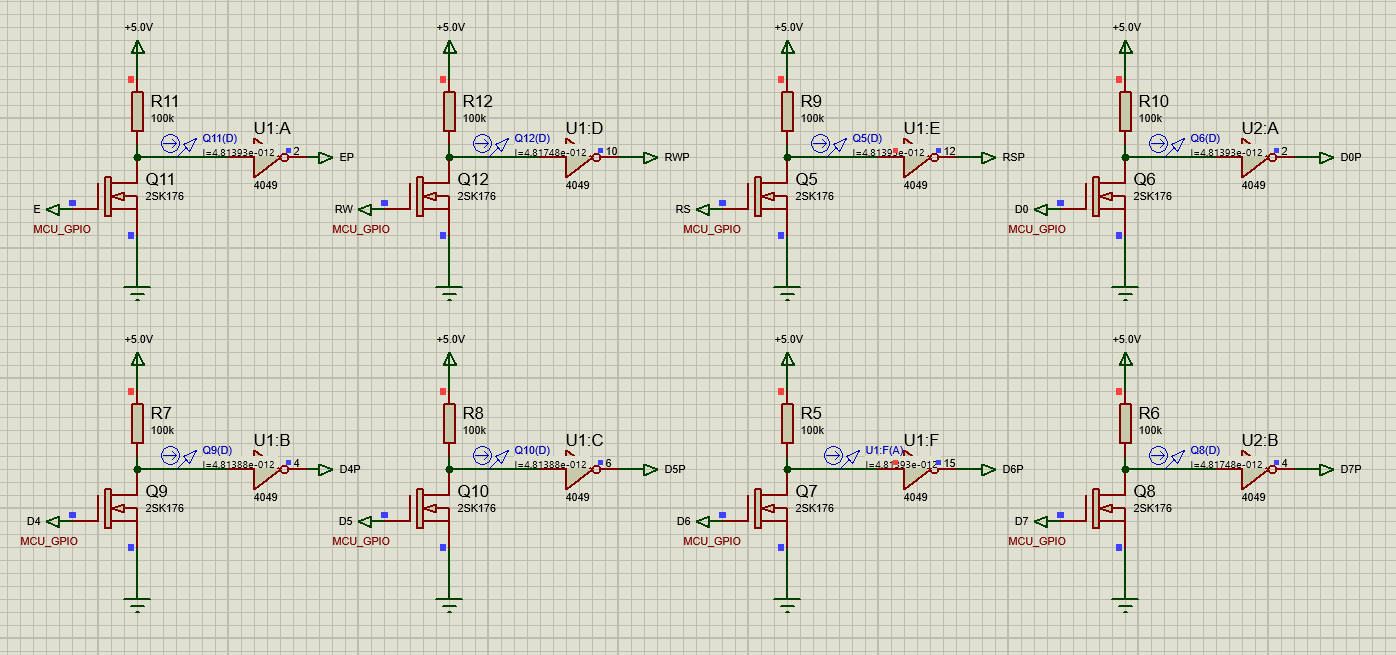
[picture p93: figure]
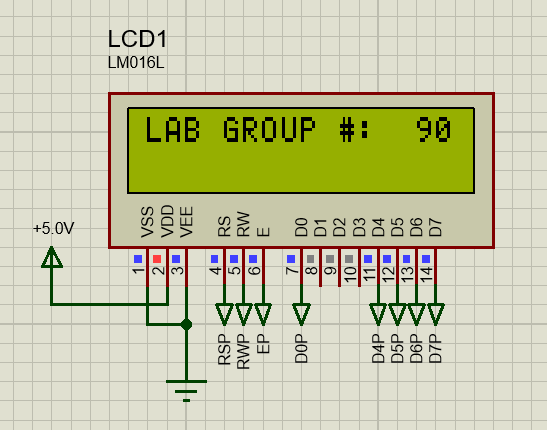
[picture p94: figure]
