bcimring/wheelchair_controller/lab_4/ECE298_Lab4_3D_Bottom_View.pdf

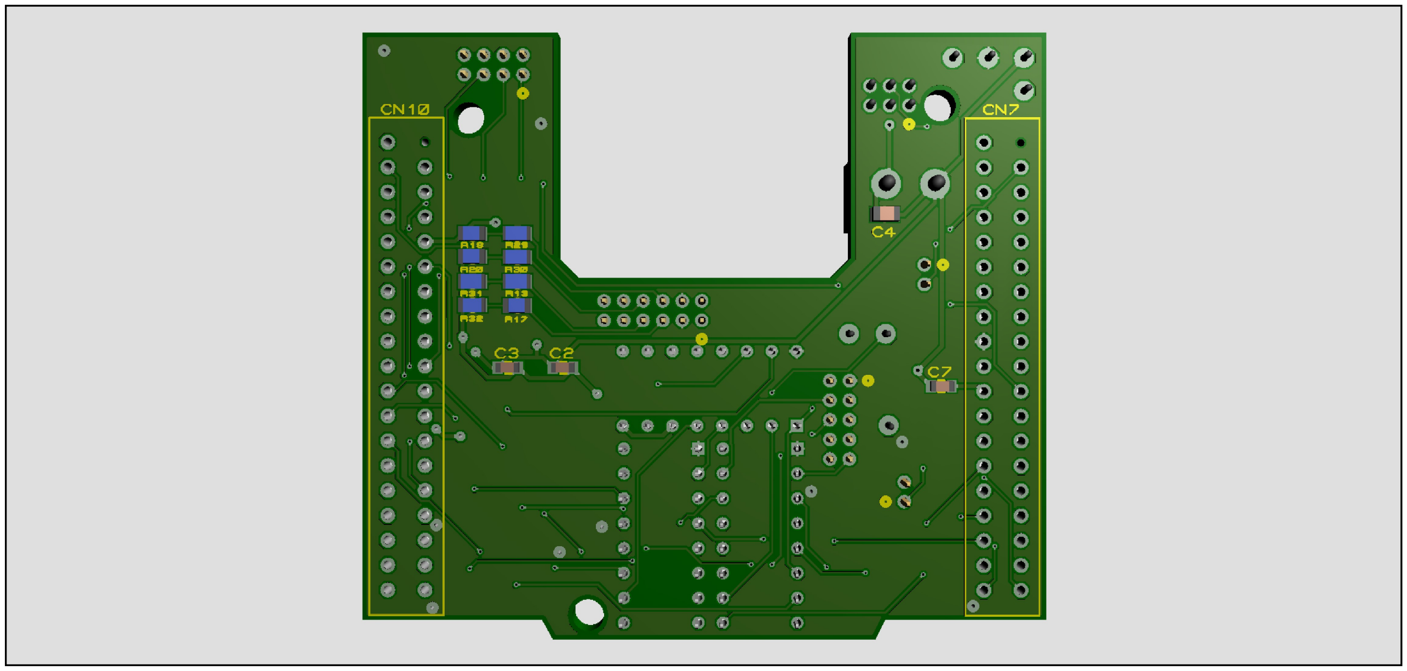
[picture p165: figure]
