bcimring/wheelchair_controller/lab_4/ECE298_Lab4_3D_Top_View.pdf

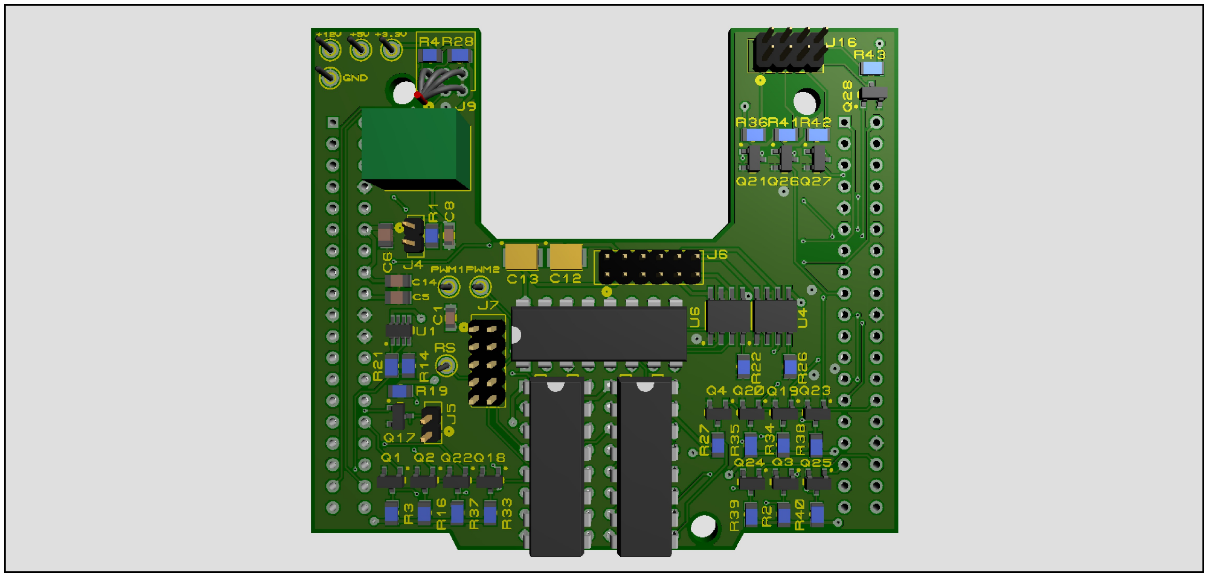
[picture p166: figure]
