bcimring/wheelchair_controller/(list of files, drawings)

Other design files:
lab_1/ECE298_Lab1_Group90.pdsprj
lab_1/Lab1_Motor_tests.pdsprj
lab_1/Project Backups/ECE298_Lab1 [20210525, 00-08-10].pdsprj
lab_1/Project Backups/ECE298_Lab1 [20210527, 22-39-00].pdsprj
lab_1/Project Backups/ECE298_Lab1 [20210528, 00-32-34].pdsprj
lab_1/Project Backups/ECE298_Lab1 [20210529, 00-53-47].pdsprj
lab_1/Project Backups/ECE298_Lab1 [20210530, 12-32-36].pdsprj
lab_1/Project Backups/ECE298_Lab1 [20210530, 14-12-56].pdsprj
lab_1/Project Backups/ECE298_Lab1 [20210530, 22-12-20].pdsprj
lab_1/Project Backups/ECE298_Lab1 [20210530, 22-12-22].pdsprj
lab_1/Project Backups/ECE298_Lab1 [20210530, 23-54-07].pdsprj
lab_1/Project Backups/ECE298_Lab1 [20210530, 23-54-10].pdsprj
lab_1/Project Backups/Lab1_Motor_tests [20210523, 15-19-32].pdsprj
lab_2/ECE298_Lab2_group_90.pdsprj
lab_2/Project Backups/ECE298_Lab2 [20210620, 13-52-42].pdsprj
lab_2/Project Backups/ECE298_Lab2 [20210620, 14-35-57].pdsprj
lab_2/Project Backups/ECE298_Lab2 [20210620, 21-11-39].pdsprj
lab_2/Project Backups/ECE298_Lab2 [20210620, 21-28-26].pdsprj
lab_2/Project Backups/ECE298_Lab2 [20210620, 21-30-24].pdsprj
lab_2/Project Backups/ECE298_Lab2 [20210620, 21-30-26].pdsprj
lab_2/Project Backups/ECE298_Lab2 [20210620, 21-30-27].pdsprj
lab_2/Project Backups/ECE298_Lab2 [20210620, 21-30-28].pdsprj
lab_2/Project Backups/ECE298_Lab2 [20210620, 23-30-04].pdsprj
lab_2/Project Backups/ECE298_Lab2 [20210620, 23-32-56].pdsprj
lab_2/Project Backups/ECE298_Lab2_group_90 [20210621, 14-14-12].pdsprj
lab_2/Project Backups/ECE298_Lab2_group_90 [20210621, 14-28-32].pdsprj
lab_2/Project Backups/ECE298_Lab2_group_90 [20210621, 14-29-41].pdsprj
lab_3/Lab3_Group90/ECE298_Lab3.pdsprj
lab_3/Project Backups/ECE298_Lab3 [20210708, 02-09-18].pdsprj
lab_3/Project Backups/ECE298_Lab3 [20210709, 00-22-34].pdsprj
lab_3/Project Backups/ECE298_Lab3 [20210709, 01-13-37].pdsprj
lab_3/Project Backups/ECE298_Lab3 [20210711, 00-09-38].pdsprj
lab_3/Project Backups/ECE298_Lab3 [20210711, 03-41-39].pdsprj
lab_3/Project Backups/ECE298_Lab3 [20210711, 23-24-58].pdsprj
lab_3/Project Backups/ECE298_Lab3 [20210713, 00-58-53].pdsprj
lab_3/Project Backups/ECE298_Lab3 [20210713, 02-17-48].pdsprj
lab_3/Project Backups/ECE298_Lab3 [20210714, 00-20-50].pdsprj
lab_3/Project Backups/ECE298_Lab3 [20210714, 16-31-39].pdsprj
lab_4/ECE298_Lab4.pdsprj
lab_4/Project Backups/ECE298_Lab4 [20210801, 21-52-19].pdsprj
lab_4/Project Backups/ECE298_Lab4 [20210801, 21-52-58].pdsprj
lab_4/Project Backups/ECE298_Lab4 [20210802, 18-20-05].pdsprj
lab_4/Project Backups/ECE298_Lab4 [20210802, 18-29-48].pdsprj
lab_4/Project Backups/ECE298_Lab4 [20210802, 18-43-45].pdsprj
lab_4/Project Backups/ECE298_Lab4 [20210803, 12-43-25].pdsprj
lab_4/Project Backups/ECE298_Lab4 [20210803, 12-48-42].pdsprj
lab_4/Project Backups/ECE298_Lab4 [20210803, 13-07-46].pdsprj
lab_4/Project Backups/ECE298_Lab4 [20210804, 21-59-34].pdsprj
lab_4/Project Backups/ECE298_Lab4 [20210804, 21-59-35].pdsprj
lab_4/Project Backups/Project Backups/ECE298_Lab4 [20210801, 23-39-13] [20210802, 17-29-28].pdsprj
lab_4/Project Backups/Project Backups/ECE298_Lab4 [20210801, 23-39-13] [20210802, 17-34-15].pdsprj
lab_4/Project Backups/Project Backups/ECE298_Lab4 [20210801, 23-39-13] [20210802, 17-50-43].pdsprj
lab_4/Project Backups/Project Backups/ECE298_Lab4 [20210801, 23-39-13] [20210802, 17-54-43].pdsprj
lab_4/Project Backups/Project Backups/ECE298_Lab4 [20210801, 23-39-13] [20210802, 18-02-42].pdsprj
