bcimring/wheelchair_controller/lab_3/lab_3/Core/Inc/main.h

#define BAT_IN_Pin GPIO_PIN_0
#define BAT_IN_GPIO_Port GPIOC
#define POT_IN1_Pin GPIO_PIN_1
#define POT_IN1_GPIO_Port GPIOC
#define POT_IN2_Pin GPIO_PIN_2
#define POT_IN2_GPIO_Port GPIOC
#define LED_OUT5_Pin GPIO_PIN_3
#define LED_OUT5_GPIO_Port GPIOC
#define PWM_CH1_Pin GPIO_PIN_0
#define PWM_CH1_GPIO_Port GPIOA
#define PWM_CH2_Pin GPIO_PIN_1
#define PWM_CH2_GPIO_Port GPIOA
#define LCD_OUT4_Pin GPIO_PIN_4
#define LCD_OUT4_GPIO_Port GPIOA
#define LCD_OUT5_Pin GPIO_PIN_5
#define LCD_OUT5_GPIO_Port GPIOA
#define LCD_OUT6_Pin GPIO_PIN_6
#define LCD_OUT6_GPIO_Port GPIOA
#define LCD_OUT7_Pin GPIO_PIN_7
#define LCD_OUT7_GPIO_Port GPIOA
#define LCD_EN_Pin GPIO_PIN_0
#define LCD_EN_GPIO_Port GPIOB
#define LCD_RS_Pin GPIO_PIN_1
#define LCD_RS_GPIO_Port GPIOB
#define LCD_RW_Pin GPIO_PIN_2
#define LCD_RW_GPIO_Port GPIOB
#define MUX_SELECT2_Pin GPIO_PIN_14
#define MUX_SELECT2_GPIO_Port GPIOB
#define MUX_SELECT1_Pin GPIO_PIN_15
#define MUX_SELECT1_GPIO_Port GPIOB
#define DC_MOTOR_1_Q1_Pin GPIO_PIN_6
#define DC_MOTOR_1_Q1_GPIO_Port GPIOC
#define DC_MOTOR_1_Q1_EXTI_IRQn EXTI9_5_IRQn
#define DC_MOTOR_1_Q2_Pin GPIO_PIN_7
#define DC_MOTOR_1_Q2_GPIO_Port GPIOC
#define DC_MOTOR_2_Q1_Pin GPIO_PIN_8
#define DC_MOTOR_2_Q1_GPIO_Port GPIOC
#define DC_MOTOR_2_Q1_EXTI_IRQn EXTI9_5_IRQn
#define DC_MOTOR_2_Q2_Pin GPIO_PIN_9
#define DC_MOTOR_2_Q2_GPIO_Port GPIOC
#define LED_OUT4_Pin GPIO_PIN_4
#define LED_OUT4_GPIO_Port GPIOB
#define LED_OUT3_Pin GPIO_PIN_5
#define LED_OUT3_GPIO_Port GPIOB
#define LED_OUT2_Pin GPIO_PIN_6
#define LED_OUT2_GPIO_Port GPIOB
#define LED_OUT1_Pin GPIO_PIN_7
#define LED_OUT1_GPIO_Port GPIOB
