bcimring/wheelchair_controller/(commit log)

2021-05-12 bill of materials
2021-05-12 Added parts to selection
    [ECE298_Lab1 [20210512, 10-26-08].pdsprj, ECE298_Lab1.pdsprj]
2021-05-13 outline for testing components
    [ECE298_Lab1 [20210513, 16-13-45].pdsprj, ECE298_Lab1 [20210513, 16-13-53].pdsprj, ECE298_Lab1.pdsprj]
2021-05-14 Anweshi's examples
    [ECE298_Lab1 [20210514, 15-51-35].pdsprj, ECE298_Lab1.pdsprj]
2021-05-14 tested brushless dc motor
    [ECE298_Lab1 [20210514, 18-40-01].pdsprj, ECE298_Lab1 [20210514, 18-40-45].pdsprj, ECE298_Lab1 [20210514, 19-00-34].pdsprj, ECE298_Lab1 [20210514, 19-00-35].pdsprj, ECE298_Lab1 [20210514, 19-53-22].pdsprj, ECE298_Lab1.pdsprj]
2021-05-15 Testing of brushless motor
2021-05-15 Lab report for battery level sensor
2021-05-15 Battery-level sensor circuit
    [ECE298_Lab1 [20210515, 18-12-25].pdsprj, ECE298_Lab1.pdsprj]
2021-05-16 Transistor circuit for motor
    [ECE298_Lab1 [20210512, 10-26-08].pdsprj, ECE298_Lab1 [20210516, 14-42-15].pdsprj, ECE298_Lab1.pdsprj]
2021-05-16 writeup for reverse motor direction
2021-05-18 Fixed motor circuit
    [ECE298_Lab1 [20210513, 16-13-45].pdsprj, ECE298_Lab1 [20210517, 21-52-31].pdsprj, ECE298_Lab1.pdsprj]
2021-05-19 playing with LCD
    [ECE298_Lab1 [20210513, 16-13-53].pdsprj, ECE298_Lab1 [20210519, 14-11-31].pdsprj, ECE298_Lab1.pdsprj]
2021-05-21 fix motor part
2021-05-23 lcd working
    [ECE298_Lab1.pdsprj]
2021-05-23 minor changes to schematics
    [ECE298_Lab1 [20210514, 15-51-35].pdsprj, ECE298_Lab1 [20210514, 18-40-01].pdsprj, ECE298_Lab1 [20210514, 18-40-45].pdsprj, ECE298_Lab1 [20210523, 13-47-25].pdsprj, ECE298_Lab1 [20210523, 13-48-46].pdsprj, ECE298_Lab1 [20210523, 15-19-24].pdsprj, ECE298_Lab1.pdsprj, Lab1_Motor_tests [20210523, 15-19-32].pdsprj]
2021-05-24 Added schematics for switch, LED and potentiometer
    [ECE298_Lab1.pdsprj]
2021-05-25 changes to testing circuits
    [ECE298_Lab1 [20210514, 19-00-34].pdsprj, ECE298_Lab1 [20210514, 19-00-35].pdsprj, ECE298_Lab1 [20210514, 19-53-22].pdsprj, ECE298_Lab1 [20210515, 18-12-25].pdsprj, ECE298_Lab1 [20210516, 14-42-15].pdsprj, ECE298_Lab1 [20210517, 21-52-31].pdsprj, ECE298_Lab1 [20210524, 22-05-40].pdsprj, ECE298_Lab1 [20210524, 22-55-17].pdsprj]
2021-05-30 latest schematics
    [ECE298_Lab1 [20210519, 14-11-31].pdsprj, ECE298_Lab1 [20210523, 13-47-25].pdsprj, ECE298_Lab1 [20210523, 13-48-46].pdsprj, ECE298_Lab1 [20210523, 15-19-24].pdsprj, ECE298_Lab1 [20210524, 22-05-40].pdsprj, ECE298_Lab1 [20210527, 22-39-00].pdsprj, ECE298_Lab1 [20210528, 00-32-34].pdsprj, ECE298_Lab1 [20210529, 00-53-47].pdsprj]
2021-05-31 Final schematic
    [ECE298_Lab1.pdsprj]
2021-06-03 lab 2
    [ECE298_Lab1 [20210524, 22-55-17].pdsprj, ECE298_Lab1 [20210524, 23-41-58].pdsprj, ECE298_Lab1 [20210524, 23-52-00].pdsprj, ECE298_Lab1 [20210525, 00-07-58].pdsprj, ECE298_Lab1 [20210530, 22-12-20].pdsprj, ECE298_Lab1 [20210530, 22-12-22].pdsprj, ECE298_Lab1 [20210530, 23-54-07].pdsprj, ECE298_Lab1 [20210530, 23-54-10].pdsprj]
2021-06-03 lab 2 start
    [ECE298_Lab2 [20210603, 18-20-23].pdsprj, ECE298_Lab2 [20210603, 18-29-57].pdsprj, ECE298_Lab2.pdsprj]
2021-06-04 motor description
    [ECE298_Lab1_Group90.pdsprj]
2021-06-09 fixed wire connections
    [ECE298_Lab2 [20210609, 00-07-21].pdsprj, ECE298_Lab2 [20210609, 00-07-22].pdsprj, ECE298_Lab2 [20210609, 17-29-09].pdsprj, ECE298_Lab2 [20210609, 17-30-13].pdsprj, ECE298_Lab2.pdsprj]
2021-06-11 sch symbols
    [ECE298_Lab2 [20210611, 17-56-14].pdsprj, ECE298_Lab2.pdsprj]
2021-06-14 voltage translation for LCD
    [ECE298_Lab2 [20210613, 21-58-34].pdsprj, ECE298_Lab2.pdsprj]
2021-06-14 Added potentiometer, LEDs and switch details
2021-06-15 pics for simulations
    [ECE298_Lab2 [20210603, 18-20-23].pdsprj, ECE298_Lab2 [20210603, 18-29-57].pdsprj, ECE298_Lab2 [20210609, 00-07-21].pdsprj, ECE298_Lab2 [20210609, 00-07-22].pdsprj, ECE298_Lab2 [20210609, 17-29-09].pdsprj, ECE298_Lab2 [20210609, 17-30-13].pdsprj, ECE298_Lab2 [20210611, 17-56-14].pdsprj, ECE298_Lab2 [20210613, 21-58-34].pdsprj]
2021-06-18 pretty schematics'
    [ECE298_Lab2.pdsprj]
2021-06-19 Added schematics for potentiometer, switch, LEDs
2021-06-21 final sch
    [ECE298_Lab2 [20210615, 09-33-08].pdsprj, ECE298_Lab2 [20210615, 10-01-34].pdsprj, ECE298_Lab2 [20210615, 10-15-53].pdsprj, ECE298_Lab2 [20210615, 10-18-10].pdsprj, ECE298_Lab2 [20210615, 10-21-37].pdsprj, ECE298_Lab2 [20210615, 10-23-51].pdsprj, ECE298_Lab2 [20210615, 10-31-47].pdsprj, ECE298_Lab2 [20210618, 17-40-20].pdsprj]
2021-06-21 final final final sch
    [ECE298_Lab2 [20210618, 17-49-53].pdsprj, ECE298_Lab2 [20210620, 23-32-56].pdsprj, ECE298_Lab2.pdsprj]
2021-06-21 final lab 2
    [ECE298_Lab2_group_90.pdsprj]
2021-06-29 first instance of PWM and ADC
    [ECE298_Lab3 [20210627, 17-25-12].pdsprj, ECE298_Lab3 [20210627, 17-51-02].pdsprj, ECE298_Lab3 [20210627, 19-55-32].pdsprj, ECE298_Lab3 [20210627, 20-28-36].pdsprj, ECE298_Lab3 [20210628, 18-28-25].pdsprj, ECE298_Lab3 [20210628, 19-46-13].pdsprj, ECE298_Lab3 [20210628, 20-36-06].pdsprj, ECE298_Lab3.pdsprj]
2021-06-29 reading rpm
    [ECE298_Lab3 [20210629, 18-20-28].pdsprj, ECE298_Lab3 [20210629, 19-56-53].pdsprj, ECE298_Lab3.pdsprj]
2021-06-30 direction of rotation
    [ECE298_Lab3 [20210630, 18-36-26].pdsprj, ECE298_Lab3.pdsprj]
2021-07-02 connect all input and output
    [ECE298_Lab3 [20210627, 17-25-12].pdsprj, ECE298_Lab3 [20210627, 17-51-02].pdsprj, ECE298_Lab3 [20210627, 19-55-32].pdsprj, ECE298_Lab3 [20210627, 20-28-36].pdsprj, ECE298_Lab3 [20210628, 18-28-25].pdsprj, ECE298_Lab3 [20210628, 19-46-13].pdsprj, ECE298_Lab3 [20210628, 20-36-06].pdsprj, ECE298_Lab3 [20210701, 06-42-54].pdsprj]
2021-07-04 sense motor speed
    [ECE298_Lab3 [20210629, 18-20-28].pdsprj, ECE298_Lab3 [20210629, 19-56-53].pdsprj, ECE298_Lab3 [20210630, 18-36-26].pdsprj, ECE298_Lab3 [20210701, 06-42-54].pdsprj, ECE298_Lab3 [20210702, 16-58-48].pdsprj, ECE298_Lab3 [20210702, 16-59-11].pdsprj, ECE298_Lab3 [20210702, 16-59-59].pdsprj, ECE298_Lab3 [20210702, 17-04-43].pdsprj]
2021-07-06 Added GPIO connection for switches
2021-07-08 pid control
    [ECE298_Lab3 [20210702, 23-23-07].pdsprj, ECE298_Lab3 [20210708, 02-09-18].pdsprj, ECE298_Lab3.pdsprj]
2021-07-09 finalized motor control
    [ECE298_Lab3 [20210702, 23-29-32].pdsprj, ECE298_Lab3 [20210702, 23-34-37].pdsprj, ECE298_Lab3 [20210709, 00-22-34].pdsprj, ECE298_Lab3 [20210709, 01-13-37].pdsprj, ECE298_Lab3.pdsprj]
2021-07-09 motor tests added to doc
2021-07-12 code for leds added
2021-07-12 initial switch attempt
2021-07-13 code for switch
2021-07-13 basic testing for switch
    [ECE298_Lab3 [20210703, 00-27-17].pdsprj, ECE298_Lab3 [20210713, 00-27-04].pdsprj, ECE298_Lab3.pdsprj]
2021-07-13 latest update with some tests
    [ECE298_Lab3 [20210703, 00-27-58].pdsprj, ECE298_Lab3 [20210713, 01-38-06].pdsprj, ECE298_Lab3.pdsprj]
2021-07-13 all code done, only template left
    [ECE298_Lab3 [20210703, 00-28-39].pdsprj, ECE298_Lab3 [20210713, 02-54-19].pdsprj, ECE298_Lab3.pdsprj]
2021-07-14 Final push for lab 3
    [ECE298_Lab3 [20210703, 16-26-20].pdsprj, ECE298_Lab3 [20210704, 15-21-45].pdsprj, ECE298_Lab3 [20210704, 15-45-33].pdsprj, ECE298_Lab3 [20210711, 00-09-38].pdsprj, ECE298_Lab3 [20210711, 03-41-39].pdsprj, ECE298_Lab3 [20210711, 23-24-58].pdsprj, ECE298_Lab3 [20210713, 00-58-53].pdsprj, ECE298_Lab3 [20210713, 01-38-06].pdsprj]
2021-07-26 initial pcb build
    [ECE298_Lab4 [20210722, 02-44-54].pdsprj, ECE298_Lab4 [20210722, 02-44-56].pdsprj, ECE298_Lab4 [20210723, 22-07-49].pdsprj, ECE298_Lab4 [20210723, 23-45-03].pdsprj, ECE298_Lab4 [20210725, 14-23-31].pdsprj, ECE298_Lab4 [20210726, 00-20-49].pdsprj, ECE298_Lab4 [20210726, 00-41-49].pdsprj, ECE298_Lab4 [20210726, 01-26-26].pdsprj]
2021-08-01 added net classes/names & connectors
    [ECE298_Lab4 [20210722, 02-44-54].pdsprj, ECE298_Lab4 [20210722, 02-44-56].pdsprj, ECE298_Lab4 [20210801, 17-40-08].pdsprj, ECE298_Lab4 [20210801, 17-52-15].pdsprj, ECE298_Lab4.pdsprj]
2021-08-02 no more errors on netlist
    [ECE298_Lab4 [20210725, 14-23-31].pdsprj, ECE298_Lab4 [20210726, 00-20-49].pdsprj, ECE298_Lab4 [20210726, 00-41-49].pdsprj, ECE298_Lab4 [20210726, 01-26-26].pdsprj, ECE298_Lab4 [20210726, 01-32-39].pdsprj, ECE298_Lab4 [20210726, 01-37-30].pdsprj, ECE298_Lab4 [20210801, 19-50-07].pdsprj, ECE298_Lab4 [20210801, 20-45-28].pdsprj]
2021-08-02 test pins added and no errors on netlist
    [ECE298_Lab4 [20210801, 17-40-08].pdsprj, ECE298_Lab4 [20210801, 21-44-20].pdsprj, ECE298_Lab4.pdsprj]
2021-08-02 Final PCB push
    [ECE298_Lab4 [20210801, 19-50-07].pdsprj, ECE298_Lab4 [20210801, 20-45-28].pdsprj, ECE298_Lab4 [20210801, 20-48-01].pdsprj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]
2021-08-03 Final product
    [ECE298_Lab4 - CADCAM Bottom Copper.GBR, ECE298_Lab4 - CADCAM Bottom SMT Paste.GBR, ECE298_Lab4 - CADCAM Bottom Silk Screen.GBR, ECE298_Lab4 - CADCAM Bottom Solder Resist.GBR, ECE298_Lab4 - CADCAM Drill TOP-BOT Plated.GBR, ECE298_Lab4 - CADCAM Top Copper.GBR, ECE298_Lab4 - CADCAM Top SMT Paste.GBR, ECE298_Lab4 - CADCAM Top Silk Screen.GBR]
